AndreaFavero71/CUBOTino_micro/src/Cubotino_m_settings_default.txt

{
"frameless_cube": "auto",
"disp_width": "240",
"disp_height": "135",
"disp_offsetL": "40",
"disp_offsetT": "53",
"camera_width_res": "640",
"camera_height_res": "480",
"s_mode": "7",
"kl": "0.95",
"x_l": 0,
"x_r": 0,
"y_u": 0,
"y_b": 0,
"warp_fraction": 7.8,
"warp_slicing": 3,
"square_ratio": "1",
"rhombus_ratio": "0.3",
"delta_area_limit": "0.7",
"sv_max_moves": "20",
"sv_max_time": "2",
"collage_w": "1024",
"marg_coef": "0.1",
"cam_led_bright": ".5",
"detect_timeout": "40",
"show_time": "7",
"warn_time": "1.5",
"quit_time": "4.5",
"cover_self_close": "true",
"vnc_delay": "0.5",
"built_by": "",
"built_by_x": "25",
"built_by_fs": "22",
"fcs_delay": "3.0"
}
