AndreaFavero71/CUBOTino_micro/src/Cubotino_m_settings_AF3.txt

{
"frameless_cube": "auto",
"disp_width": "240",
"disp_height": "135",
"disp_offsetL": "40",
"disp_offsetT": "53",
"camera_width_res": "640",
"camera_height_res": "480",
"s_mode": "7",
"kl": "0.95",
"x_l": 32,
"x_r": 86,
"y_u": 32,
"y_b": 58,
"warp_fraction": 7.7,
"warp_slicing": 3.0,
"square_ratio": "1",
"rhombus_ratio": "0.3",
"delta_area_limit": "0.7",
"sv_max_moves": "20",
"sv_max_time": "2",
"collage_w": "1024",
"marg_coef": "0.07",
"cam_led_bright": "1.0",
"detect_timeout": "40",
"show_time": "7",
"warn_time": "1.5",
"quit_time": "4.5",
"cover_self_close": "true",
"vnc_delay": "0.5",
"built_by": "",
"built_by_x": "25",
"built_by_fs": "22"
}
