AndreaFavero71/CUBOTino_micro/stl/SOCs_-9.stl

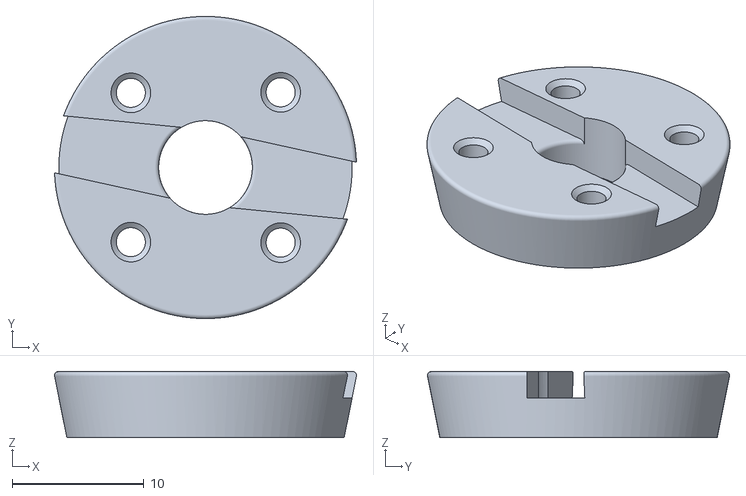
[picture p3: CAD file, 2023-03-04]
stl/SOCs_-9.stl
22.9 x 22.9 x 5.00
