AndreaFavero71/CUBOTino_micro/stp/Cover_Perfboard_hole.stp

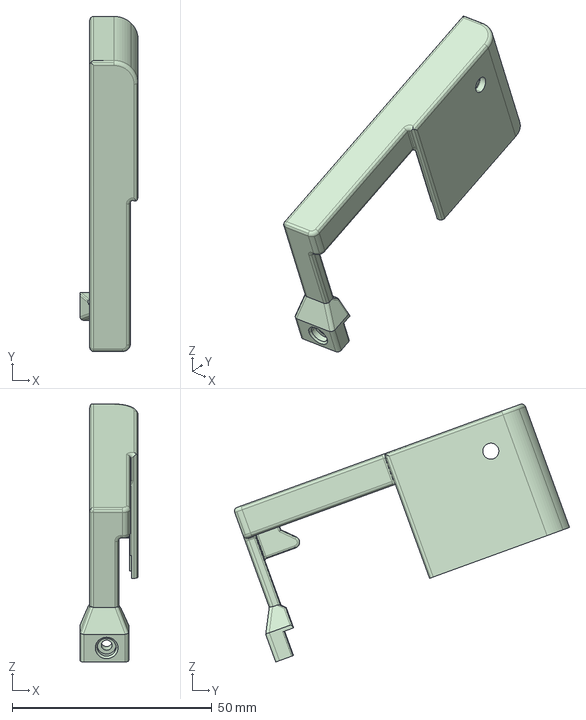
[picture p4: CAD file, 2024-01-12]
stp/Cover_Perfboard_hole.stp
14.6 x 83.9 x 64.6 mm
