AndreaFavero71/CUBOTino_micro/stp/Baseplate_addition.stp

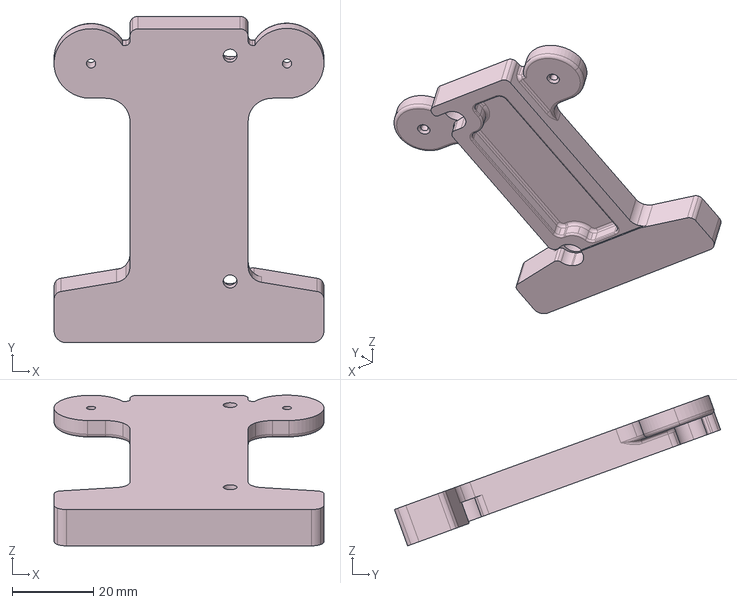
[picture p5: CAD file, 2023-05-06]
stp/Baseplate_addition.stp
66.3 x 80.1 x 37.0 mm
