AndreaFavero71/CUBOTino_micro/stp/Baseplate_L_leg.stp

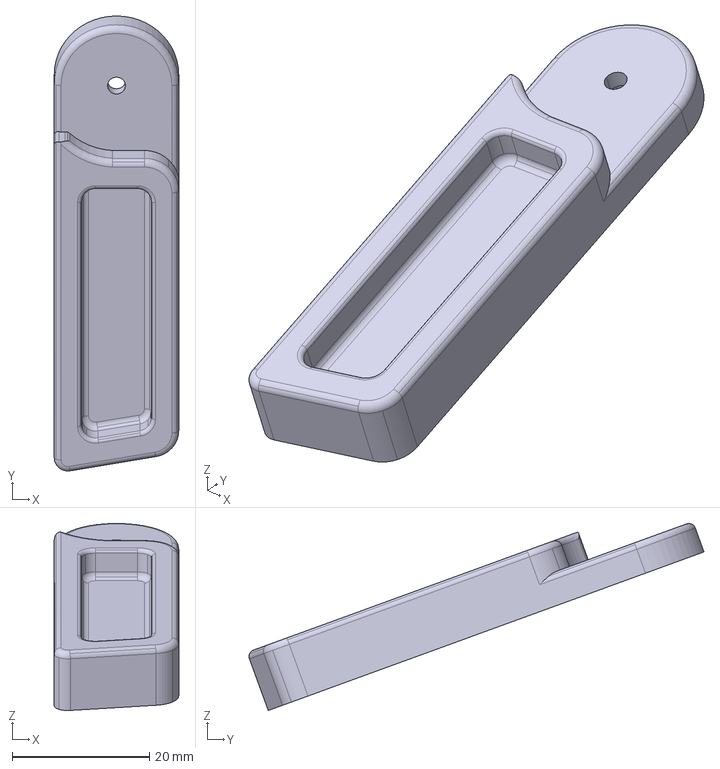
[picture p6: CAD file, 2023-05-06]
stp/Baseplate_L_leg.stp
18.1 x 66.2 x 27.2 mm
