AndreaFavero71/CUBOTino_micro/stp/Structure.stp

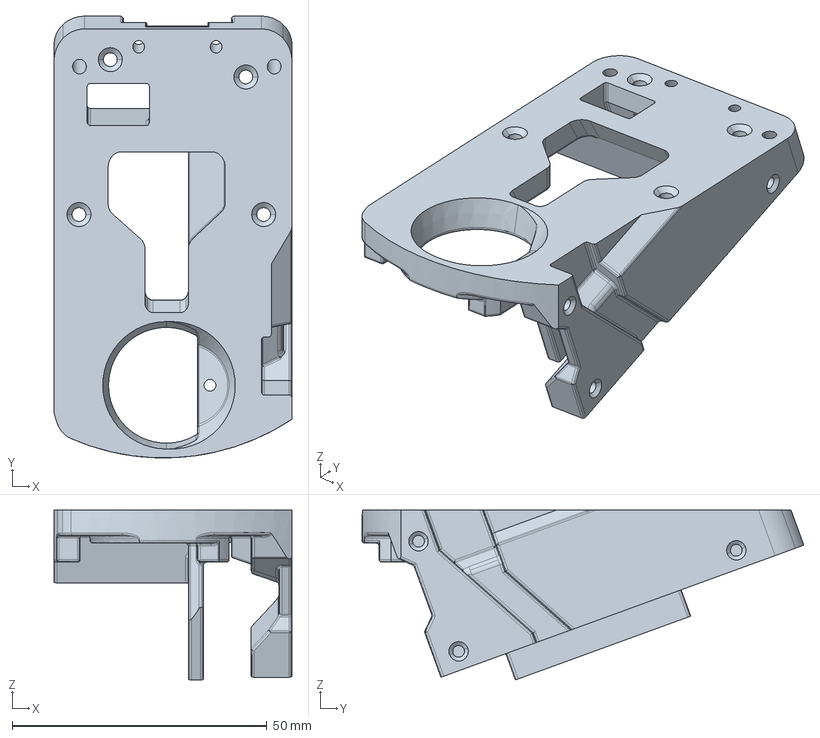
[picture p7: CAD file, 2023-03-11]
stp/Structure.stp
46.7 x 86.7 x 33.3 mm
