AndreaFavero71/CUBOTino_micro/stp/Holder.stp

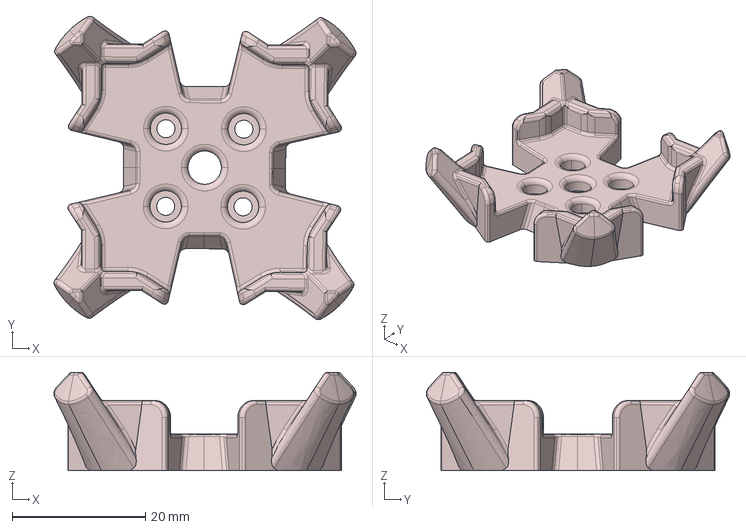
[picture p8: CAD file, 2023-03-07]
stp/Holder.stp
45.3 x 45.5 x 14.7 mm
