AndreaFavero71/CUBOTino_micro/stp/PiCamera_holder.stp

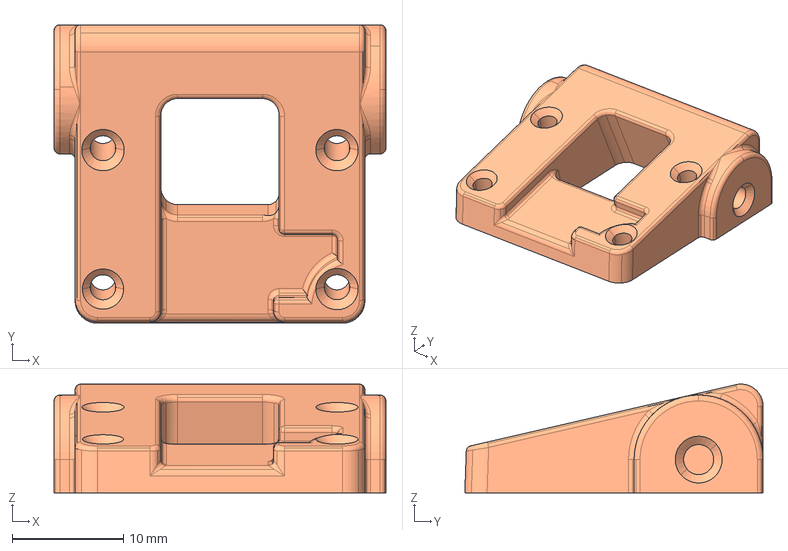
[picture p9: CAD file, 2023-03-04]
stp/PiCamera_holder.stp
29.8 x 26.8 x 9.77 mm
