AndreaFavero71/CUBOTino_micro/stp/PiCamera_frame.stp

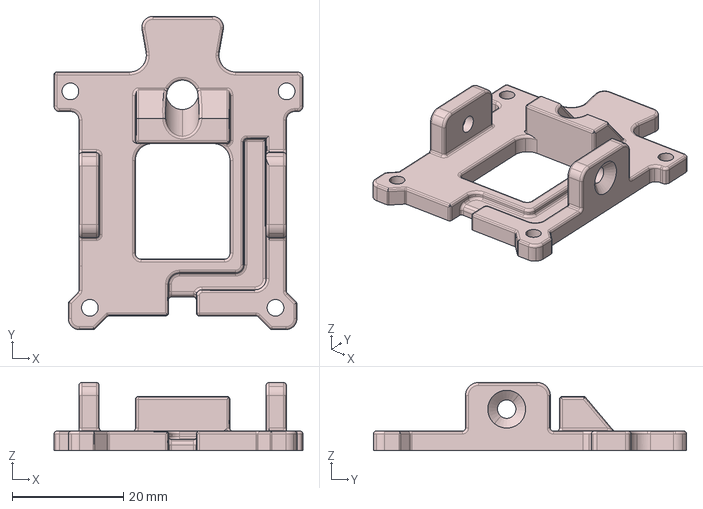
[picture p10: CAD file, 2023-03-04]
stp/PiCamera_frame.stp
44.8 x 56.3 x 12.2 mm
