AndreaFavero71/CUBOTino_micro/stp/SOC_0.stp

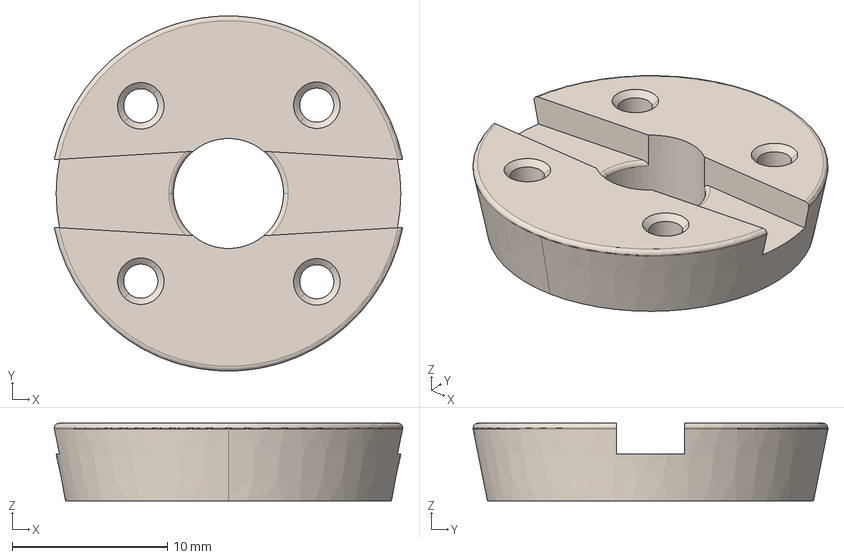
[picture p11: CAD file, 2023-03-04]
stp/SOC_0.stp
22.5 x 22.9 x 5.00 mm
