AndreaFavero71/CUBOTino_micro/stp/Baseplate.stp

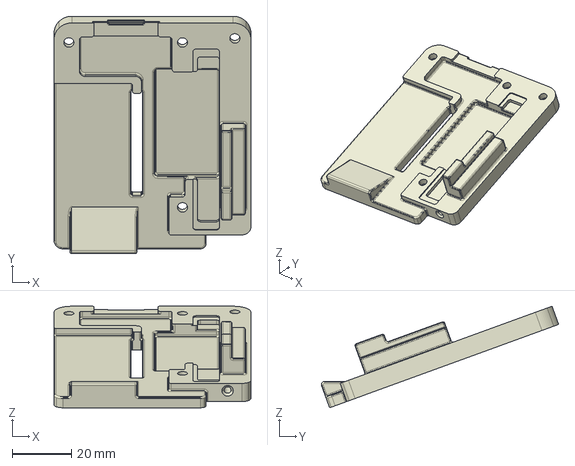
[picture p12: CAD file, 2023-03-04]
stp/Baseplate.stp
66.3 x 79.8 x 34.2 mm
