AndreaFavero71/CUBOTino_micro/stp/Hinge.stp

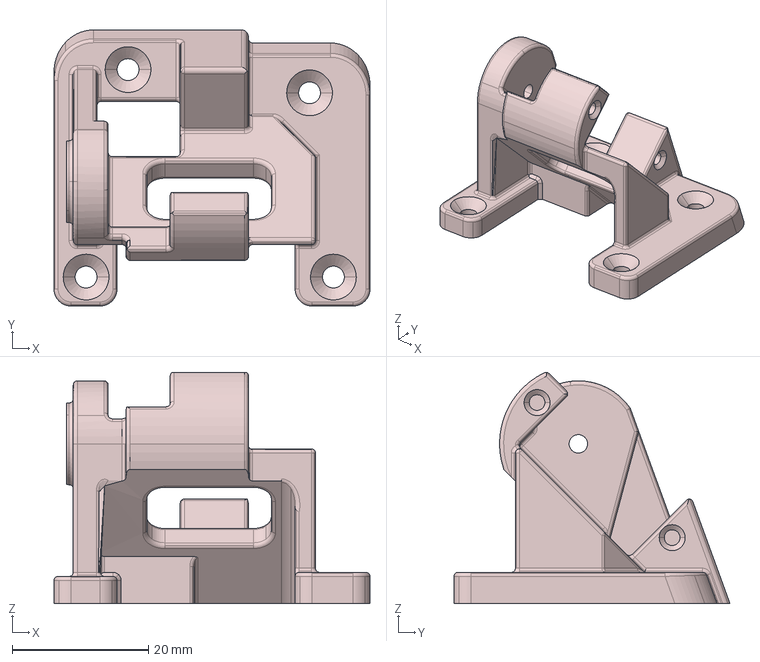
[picture p13: CAD file, 2023-03-04]
stp/Hinge.stp
46.3 x 40.5 x 33.9 mm
