AndreaFavero71/CUBOTino_micro/stp/Lifter.stp

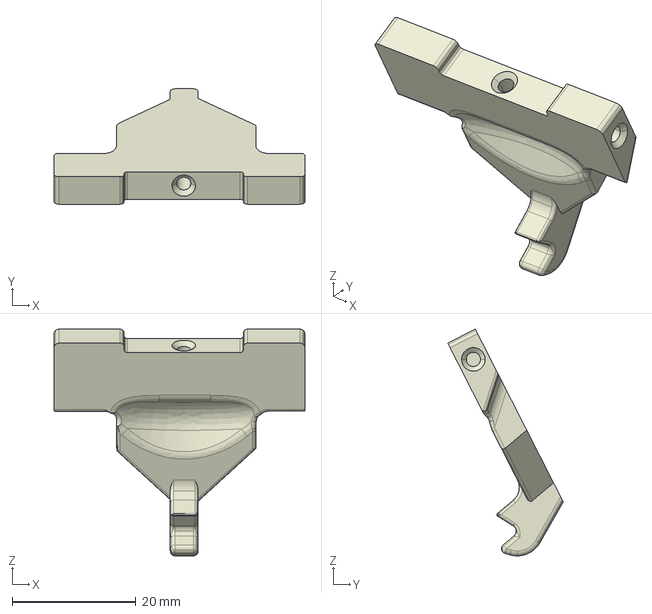
[picture p14: CAD file, 2023-03-04]
stp/Lifter.stp
40.6 x 18.7 x 36.7 mm
