AndreaFavero71/CUBOTino_micro/stp/Top_cover.stp

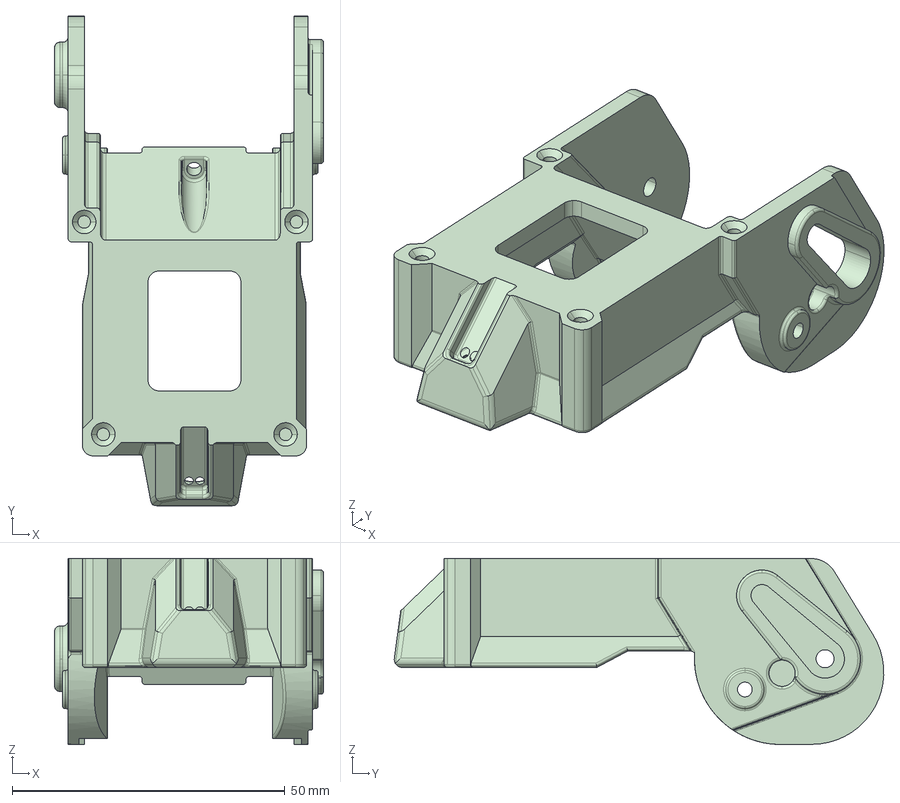
[picture p15: CAD file, 2023-03-04]
stp/Top_cover.stp
49.3 x 89.7 x 34.1 mm
