AndreaFavero71/CUBOTino_micro/(list of files, cad)

Other CAD files:
stp/Baseplate_R_leg.stp
stp/Cover_led_hole.stp
stp/Cover.stp
stp/SOC_+5.stp
stp/SOC_+9.stp
stl/Baseplate_L_leg.stl
stl/Baseplate_R_leg.stl
stl/Baseplate_addition.stl
stl/Cover.stl
stl/Cover_Perfboard_hole.stl
stl/Cover_led_hole.stl
stl/Lifter.stl
stl/SOC_+5.stl
stl/SOC_+9.stl
stl/SOC_-5.stl
stl/SOC_0.stl
stp/SOC_-5.stp
stp/SOC_-9.stp
