AndreaFavero71/CUBOTino_micro/src/Cubotino_m.py

#!/usr/bin/python
# coding: utf-8

""" 
#############################################################################################################
#  Andrea Favero, 15 April 2024
#
#
#  This script relates to CUBOTino micro, an extremely small and simple Rubik's cube solver robot 3D printed
#  CUBOTino micro is the smallest version of the CUBOTino versions
#  Demo at https://youtu.be/EbOHhvg2tJE
#  Instructions: https://www.instructables.com/member/AndreaFavero/instructables/
#
#  This is the core script, that interracts with few other files.
#  Many functions of this code have been developed on 2021, for my first robot (https://youtu.be/oYRXe4NyJqs).
#
#  The cube status is detected via a camera system (piCamera) and OpenCV .
#  Kociemba solver is used foer the cube solution (from: https://github.com/hkociemba/RubiksCube-TwophaseSolver)
#  Credits to Mr. Kociemba for his great job !
#  Search for CUBOTino autonomous on www.intructable.com, to find more info about this robot.
#
#  Developped on:
#  - Raspberry Pi Zero 2
#  - Raspberry Pi OS (Legacy) A port of Debian Buster with security updates and desktop environment
#    (Linux raspberry 5.10.103-v7+ #1529 SMP Tue 8 12:21:37 GMT 2022 armv71 GNU/Linux)
#  - OpenCV cv2 ver: 4.1.0
#  - PiCamera v1.3
#  - Numpy: 1.21.4
#
#############################################################################################################
"""

# __version__ variable
version = '1.1   15 April 2024'


################  setting argparser for robot remote usage, and other settings  #################
import argparse

# argument parser object creation
parser = argparse.ArgumentParser(description='CLI arguments for Cubotino_m.py')

# --version argument is added to the parser
parser.add_argument("-v", "--version", help='Display script version.', action='version',
                    version=f'%(prog)s ver:{version}')

# --fast argument is added to the parser
parser.add_argument("-f", "--fast", action='store_true',
                    help="From Flip-Up to close_cover in one movement instead of two")

# --debug argument is added to the parser
parser.add_argument("-d", "--debug", action='store_true',
                    help="Activates printout of settings, variables and info for debug purpose")

# --no_animation argument is added to the parser
parser.add_argument("--no_animation", action='store_true',
                    help="Deactivates the animation on display and screen")

# --cv_wow argument is added to the parser
parser.add_argument("--cv_wow", action='store_true',
                    help="Activates the cv_wow (image analysis steps) on screen")

# --F_deg argument is added to the parser
parser.add_argument("-F", "--F_deg", action='store_true',
                    help="CPU temperature in Fahrenheit degrees")

# --cycles argument is added to the parser
parser.add_argument("-c", "--cycles", type=int, 
                    help="Input the number of automated scrambling and solving cycles")

# --pause argument is added to the parser
parser.add_argument("-p", "--pause", type=int, 
                    help="Input the pause time, in secs, between automated cycles")

# --shutoff argument is added to the parser
parser.add_argument("-s", "--shutoff", action='store_true',
                    help="Shuts the RPI off, after the automated scrambling and solving cycles")

# --timer argument is added to the parser
parser.add_argument("-t", "--timer", action='store_true',
                    help="Timer is visualized after the scrambling function (max 1h)")

# --picamera_test argument is added to the parser
parser.add_argument("--picamera_test", action='store_true',
                    help="Visualizes PiCamera images for test purpose")

# --no_motors argument is added to the parser
parser.add_argument("--no_motors", action='store_true',
                    help="Excludes servos and motor for test purpose")

# --no_btn argument is added to the parser
parser.add_argument("--no_btn", action='store_true',
                    help="Starts the first solving cycles without using the button")

args = parser.parse_args()   # argument parsed assignement
# ###############################################################################################







def import_parameters(debug=False):
    """ Function to import parameters from a json file, to make easier to list/document/change the variables
        that are expected to vary on each robot."""
       
    from Cubotino_m_settings_manager import settings as settings  # settings manager Class
    
    global frameless_cube, camera_width_res, camera_height_res, s_mode
    global kl, x_l, x_r, y_u, y_b, w_f, w_s, square_ratio, rhombus_ratio
    global delta_area_limit, sv_max_moves, sv_max_time, collage_w, marg_coef, cam_led_bright, cam_led_auto
    global detect_timeout, show_time, warn_time, quit_time, cover_self_close, vnc_delay, fcs_delay
    global built_by, built_by_x, built_by_fs

    
    
    try:                                               # tentative
        sett = settings.get_settings()                 # settings are retrieved from the settings Class
        frameless_cube = sett['frameless_cube']        # cube frameless (with/without black frame around the facelets)
        camera_width_res = sett['camera_width_res']    # Picamera resolution on width 
        camera_height_res = sett['camera_height_res']  # Picamera resolution on heigh
        s_mode = sett['s_mode']                        # camera setting mode (pixels binning)
        kl = sett['kl']                                # coff. for PiCamera stabili acceptance
        x_l = sett['x_l']                              # image crop on left (before warping)
        x_r = sett['x_r']                              # image crop on right (before warping)
        y_u = sett['y_u']                              # image crop on top (before warping)
        y_b = sett['y_b']                              # image crop on bottom (before warping)
        w_f = sett['warp_fraction']                    # coeff for warping the image
        w_s = sett['warp_slicing']                     # coeff for cropping the bottom warped image

        square_ratio = sett['square_ratio']            # acceptance threshold for square sides difference
        rhombus_ratio = sett['rhombus_ratio']          # acceptance threshold for rhombus axes difference
        delta_area_limit = sett['delta_area_limit']    # acceptance threshold for facelet area dev from median
        sv_max_moves = sett['sv_max_moves']            # max moves requested to the Kociemba solver
        sv_max_time = sett['sv_max_time']              # timeout requested to the Kociemba solver
        collage_w = sett['collage_w']                  # image width for unfolded cube collage
        marg_coef = sett['marg_coef']                  # cropping margin arounf faces for immage collage
        cam_led_bright = sett['cam_led_bright']        # PWM level for the 3W led at Top_cover
        detect_timeout = sett['detect_timeout']        # timeout for cube status detection
        show_time = sett['show_time']                  # showing time of the unfolded cube image collage
        warn_time = sett['warn_time']                  # solve button pressing time before get a worning
        quit_time = sett['quit_time']                  # solve button pressing time before the quit process
        vnc_delay = sett['vnc_delay']                  # delay for cube moving to next face at scan (for VNC viewer)
        built_by = sett['built_by']                    # maker's name to add on the Cubotino logo
        built_by_x = sett['built_by_x']                # x coordinate for maker's name on display
        built_by_fs = sett['built_by_fs']              # font size for the maker's name on display
        fcs_delay = sett['fcs_delay']                  # delay in secs to switch to Fix Coordinates System for facelets position
        cover_self_close = sett['cover_self_close']    # cover_self_close parameter 
        
        if debug:                                      # case debug variable is set true
            fname = settings.get_settings_fname()      # settings filename is retrieved
            print('\nImporting servos settings from the text file:', fname)  # feedback is printed to the terminal
            for param, s in sett.items():              # iteration over the settings dict
                print(param,': ', s)                   # feedback is printed to the terminal
            print()                                    # prints an empty line
        
        return True, sett                              # return True for loaded settings and the sett dictionary
    
    except:   # exception will be raised if json keys differs, or parameters cannot be converted to int/float
        print('Error at imported_parameters function in Cubotino_m.py')   # feedback is printed to the terminal                                  
        return False, ''                               # return robot_init_status variable, that is False








def import_libraries():
    """ Import of the needed libraries.
        These librries are imported after those needed for the display management.
        Kociemba solver is tentatively imported considering three installation/copy methods."""
    
    global camera_set_gains, dist, PiRGBArray, PiCamera, servo, rm, GPIO, median, dt, sv, cubie
    global np, math, time, cv2, os, pathlib
    
    # import custom libraries
    from Cubotino_m_settings_manager import settings as settings   # custom library managing the settings from<>to the settings files
    import Cubotino_m_set_picamera_gain as camera_set_gains  # script that allows to fix some parameters at picamera
    import Cubotino_m_servos as servo                     # custom library controlling Cubotino servos and led module
    import Cubotino_m_moves as rm                         # custom library, traslates the cuber solution string in robot movements string

    # import non-custom libraries
    from picamera.array import PiRGBArray                 # Raspberry pi specific package for the camera, using numpy array
    from picamera import PiCamera                         # Raspberry pi specific package for the camera
    from statistics import median                         # median is used as sanity check while evaluating facelets contours
    import os.path, pathlib                               # import libraries for file and folder management
    import RPi.GPIO as GPIO                               # import RPi GPIO library
    import datetime as dt                                 # mainly used as timestamp, like on data logging
    import numpy as np                                    # data array management
    import math                                           # math package
    import time                                           # time package
    import cv2                                            # computer vision package
    import os                                             # os is imported to ensure the file presence check/make
    
    print('CV2 version: ', cv2.__version__)               # print to terminal the cv2 version
    
    # Up to here Cubotino logo is shown on display
    disp.show_on_display('LOADING', 'SOLVER', fs1=37, y2=75, fs2=42)  # feedback is printed to the display
    disp.set_backlight(1)                                 # display backlight is turned on, in case it wasn't

    
    # importing Kociemba solver (this import takes quite some time to be uploaded)
    try:
        import twophase.solver as sv                  # import Kociemba solver installed in venv
        import twophase.cubie as cubie                # import cubie Kociemba solver library part
        twophase_solver_found = True                  # boolean to track no exception on import the installed solver
        if debug:                                     # case debug variable is set true on __main__
            print('found Kociemba solver installed')  # feedback is printed to the terminal
    except:
        twophase_solver_found = False                 # boolean to track no exception on import the installed solver
    
    if not twophase_solver_found:    # case no one solver has been imported
        print('\nnot found Kociemba solver')              # feedback is printed to the terminal
        disp.show_on_display('NO SOLVER', 'FOUND', fs1=32, fs2=42) # feedback is printed to the display
        time.sleep(5)                                     # delay to let user the time to read the display
        quit_func(quit_script=True)                       # script is quitted






def press_to_start():
    """ Print PRESS TO START to display, and waits until the solve button is pressed to escape the infinite loop"""
    
    global robot_idle
    
    choice = ''                                # variable to store the user choice (solve or scramble)
    robot_idle = True                          # robot is idling
    disp.set_backlight(1)                      # display backlight is turned on, in case it wasn't
    txt1 = '<  SOLVE'                          # text to print at first row
    txt2 = '<  SCRAMBLE'                       # text to print at second row
    fs_text1 = 33                              # font size at first row
    fs_text2 = 30                              # font size at second row
    disp.show_on_display(txt1, txt2, x1=0, x2=0, y2=85, fs1=fs_text1, fs2=fs_text2)   # request user to touch the button to start a cycle
    ref_time = time.time()                     # current time is assigned to ref_time variable
    cubotino_logo = False                      # boolean to alternate text with Cubotino logo on display
    display_time = 1                           # time (in sec) for each display page
    while True:                                # infinite loop
        if time.time() - ref_time >= display_time:   # time is checked
            if not cubotino_logo:              # case cubotino logo boolean is false  
                disp.show_cubotino(built_by, built_by_x, built_by_fs)  # shows the Cubotino logo on the display, for delay time
                ref_time = time.time()         # current time is assigned to ref_time variable
                cubotino_logo = True           # cubotino logo boolean is set true                           
            else:                              # case cubotino logo boolean is false  
                disp.show_on_display(txt1, txt2, x1=0, x2=0,  y2=85, fs1=fs_text1, fs2=fs_text2)    # request user to touch the button to start a cycle
                ref_time = time.time()         # current time is assigned to ref_time variable
                cubotino_logo = False          # cubotino logo boolean is set false
            time.sleep(0.05)                   # little sleep time 
            
        if not GPIO.input(solve_btn):          # case solve_button is pressed
            return 'solve'                     # 'solve' string is returned
        
        if not GPIO.input(scramble_btn):       # case scramble_button is pressed
            return 'scramble'                  # 'solve' string is returned
        
        if not btn:                            # case the btn is ignored via argparse
            print('Cycle automatically started because of the --no_btn argument')
            return 'solve'                     # 'solve' string is returned






def check_screen_presence():
    """ Checks if a display is connected, eventually via VNC; This is not the little display (SPI) ...."""
    
    import os
    
    if 'DISPLAY' in os.environ:                          # case the environment variable DISPLAY is set to 1 (there is a display)
        if debug:                                        # case debug variable is set true on __main__
            print('display function is availbale')       # feedback is printed to the terminal
        return True                                      # function returns true, meaning there is a screen connected
    else:                                                # case the environment variable DISPLAY is set to 0 (there is NOT a display)
        if debug:                                        # case debug variable is set true on __main__
            print('display function is not availbale')   # feedback is printed to the terminal
        return False                                     # function returns false, meaning there is NOT a screen connected







def webcam():
    """ Set the camera and its resolution."""
    
    global camera, PiRGBArray
    
    # PiCamera is set as camera object, with binning. Framerate range limited to 10 allows longer exposure time (when needed)
    # higher framerate does not really speed up the cube reading process.

#     s_mode = 7    #(AF 7)   # PiCamera V1.3: sensor mode 7 means 4x4 binning, 4:3, Full Field of View
                              # PiCamera V2:   sensor mode 4 means 2x2 binning, 4:3, Full Field of View

    camera = PiCamera(sensor_mode=s_mode) #, framerate_range = (1/20, 1))  
    
    rawCapture = PiRGBArray(camera)        # returns (uncoded) RGB array from the camera
    # camera_width_res = 640   #(AF 640)   # PiCamera width resolution setting (other possible values: 800 or 1088)
    # camera_height_res = 480   #(AF 480)  # PiCamera height resolution setting (other possible values: 544 or 720)
    
    width = camera_width_res               # image width
    height = camera_height_res             # image height
    camera.resolution = (width, height)    # camera's resolution is set
    time.sleep(0.15)                       # little delay to let the camera setting
    
    binning = camera.sensor_mode           # PiCamera sensor_mode is checked
    time.sleep(0.15)                       # little delay to let the camera setting
    
    if debug:                                      # case debug variable is set true on __main__
        #  sensor_mode answer from the camera is interpreted
        if binning <=3:                            # case the binning is <=3 it means no binning
            binning='none'                         # binning variable is set to none
        elif binning == 4 or binning == 5:         # case the binning is 4 or 5 it means binning 2x2
            binning='2x2'                          # binning variable is set to 2x2
        elif binning > 5:                          # case binning is bigger than 5 it means binning 4x4
            binning='4x4 if PiCamera V1.3, 2x2 if V2'  # binning 4x4 when PiCamera V1.3, 2x2 when PiCamera V2
        print('PiCamera mode (binning):', binning) # feedback is printed to the terminal
    
    # case cube side is zero, no request to stop the robot and not automated cycles
    if side == 0 and not robot_stop and cycles_num == 0 and not picamera_test:
        print('PiCamera resolution (width x height): ',camera.resolution)  # feedback is printed to the terminal
    
    return camera, rawCapture, width, height







def robot_camera_warmup(camera, start_time):
    """ According to PiCamera documentation it is required a couple of seconds to warmup the camera.
    If the robot start-button is pressed right after placing the cube, the camera has to update the gains previously set,
    that means from when the camera was pointing the black cube support; this can take up to 20 secs to get all
    the gains stable (awb gains are rather slow to update).
    Much different is when the cube is on the cube support for few secs when the button is pressed.
    To properly cover all the possible situations, this fuction releases the camera warm-up phase only after
    all the gains are stable, meaning an absolute variation < 2% from the average of last 2 seconds."""
    

    if not robot_stop:
        disp.show_on_display('CAMERA', 'SETUP', fs1=40, fs2=42)  # feedback is printed to the display
        print('\nPiCamera: waiting for AWB and Exposure gains to get stable')  # feedback is printed to the terminal
        if debug:                              # case debug variable is set true on __main__
            print('camera set in auto mode')   # feedback is printed to the terminal
        camera.exposure_mode = 'auto' # set to auto exposure at the start, to adjust according to light conditions
        time.sleep(0.05)              # not found documentation if a delay is needed after this PiCamera setting 
        camera.awb_mode = 'auto'      # set to auto white balance at the start, to adjust according to light conditions
        time.sleep(0.05)              # not found documentation if a delay is needed after this PiCamera setting
        camera.shutter_speed = 0      # set to shutter speed to auto at the start, to adjust according to light conditions
        time.sleep(0.05)              # not found documentation if a delay is needed after this PiCamera setting
        
        a_gain_list=[]                # list to store the Picamera analog gain, during warmup period
        d_gain_list=[]                # list to store the Picamera digital gain, during warmup period
        awb_blue_list=[]              # list to store the Picamera AWB gain, for blue, during warmup period
        awb_red_list=[]               # list to store the Picamera AWB gain, for red, during warmup period
        exp_list=[]                   # list to store the Picamera exposure time, during warmup period
        t_list=[]                     # list to store the warmup progressive time of checkings
        
        # kl = 0.95     #(AF 0.95)    # lower koefficient to define acceptance bandwidth (95%)
        ku = 2-kl                     # Upper koefficient to define acceptance bandwidth (105%)
        pts = 8                       # amount of consecutive datapoints to analyse if parameters within acceptable range
        
        t_start=time.time()           # time reference is assigned as reference for the next task
        
        while time.time()-t_start <20:       # timeout for camera warm-up phase is 20 seconds
            if robot_stop:                   # case the robot has been requested to stop
                PiCamera_param=()            # empty tuple is assigned to PiCamera_param variable
                return PiCamera_param        # PiCamera_param is returned
                
            frame, w, h = read_camera()                                 # camera start reading the cube, and adjusts the awb/exposure
            a_gain=camera.analog_gain                                   # analog gain is inquired to the PiCamera
            d_gain=camera.digital_gain                                  # digital gain is inquired to the PiCamera
            awb_gains=camera.awb_gains                                  # awb blue and red gains are inquired to the PiCamera
            exposure=camera.exposure_speed                              # exposure is inquired to the PiCamera
            
            a_gain_list.append(round(float(a_gain),2))                  # analog gain is appended to a list
            d_gain_list.append(round(float(d_gain),2))                  # digital gain is appended to a list
            awb_blue_list.append(round(float(awb_gains[0]),2))          # awb blue part gain is appended to a list
            awb_red_list.append(round(float(awb_gains[1]),2))           # awb blue part gain is appended to a list
            exp_list.append(exposure)                                   # exposure time (micro secs) is appended to a list
            t_list.append(round(time.time()- t_start,2))                # time (from AWB and Exposure start adjustement) is appended to a list
            
            a_check=False                                               # a flag is negatively set for analog gain (being stable...)
            d_check=False                                               # a flag is negatively set for digital gain (being stable...)
            awb_blue_check=False                                        # a flag is negatively set for awb blue gain (being stable...)
            awb_red_check=False                                         # a flag is negatively set for awb red gain (being stable...)
            exp_check=False                                             # a flag is negatively set for the exposure time (being stable...)
            
            if len(a_gain_list) > pts:                                  # requested a minimum amount of datapoints
                check = a_gain_list[-1]/(sum(a_gain_list[-pts:])/pts)   # last analog gain value is compared to the average of last pts points
                if check > kl and check < ku:                           # if comparison within acceptance boundaries
                    a_check=True                                        # flag is positively set for this gain

                check = d_gain_list[-1]/(sum(d_gain_list[-pts:])/pts)   # last digital gain value is compared to the average of last pts points
                if check > kl and check < ku:                           # if comparison within acceptance boundaries
                    d_check=True                                        # flag is positively set for this gain               
            
                check = awb_blue_list[-1]/(sum(awb_blue_list[-pts:])/pts) # last awb_blue gain is compared to the average of last pts points
                if check > kl and check < ku:                           # if comparison within acceptance boundaries
                    awb_blue_check=True                                 # flag is positively set for this gain    
                    
                check = awb_red_list[-1]/(sum(awb_red_list[-pts:])/pts) # last awb_red gain is compared to the average of last pts points
                if check > kl and check < ku:                           # if comparison within acceptance boundarie
                    awb_red_check=True                                  # flag is positively set for this gain
                
                check = exp_list[-1]/(sum(exp_list[-pts:])/pts)         # last exposure time is compared to the average of last pts points
                if check > kl and check < ku:                           # if comparison within acceptance boundarie
                    exp_check=True                                      # flag is positively set for the exposure time                
         
                if a_check and d_check and awb_blue_check and awb_red_check and exp_check: # if all gains are stable
                    PiCamera_param=(a_gain, d_gain, awb_gains, exposure)  # latest parameters returned by the PiCamera are assigned to a tuple
                    break                                                 # camera warmup while loop cab be break

            if screen and not robot_stop:            # case screen variable is set true on __main__
                if fixWindPos:                       # case the fixWindPos variable is chosen
                    cv2.namedWindow('cube')          # create the cube window
                    cv2.moveWindow('cube', 0,0)      # move the window to (0,0)
                cv2.imshow('cube', frame)            # shows the frame 
                cv2.waitKey(1)                       # refresh time is minimized to 1ms  
        
        print(f'PiCamera: AWB and Exposure being stable in {round(t_list[-1],1)} secs')
        if screen:                                        # case screen variable is set true on __main__
            if debug:                                     # case debug variable is set true on __main__
                print('\nPiCamera warmup function:')      # feedback is printed to the terminal
                print('analog_gain_list',a_gain_list)     # feedback is printed to the terminal
                print('digital_gain_list',d_gain_list)    # feedback is printed to the terminal
                print('awb_blue_list',awb_blue_list)      # feedback is printed to the terminal
                print('awb_red_list',awb_red_list)        # feedback is printed to the terminal
                print('camera exp_list', exp_list)        # feedback is printed to the terminal
                print('time:', t_list)                    # feedback is printed to the terminal
                print('datapoints:', len(t_list))         # feedback is printed to the terminal
        
        disp.clean_display()                              # cleans the display
    
    return PiCamera_param







def robot_consistent_camera_images(camera, PiCamera_param, start_time):
    """ Picamera is left in Auto mode for Exposure and AWB, untill the first 9 facelets of first side are detected.
    For consistent color detection, on the following sides, these two parameters are retrieved from PiCamera right after
    the first side detection, and se back to PiCamera as 'manual' parametes.
    This prevents the PiCamera to keep adjusting the AWB and Exposure while reading the following 5 cube faces (sides)."""
    
    if robot_stop:        # case the robot has been requested to stop
        return            # function is terminated
    
    disp.show_on_display('MEASURING', 'EXPOSURE', fs1=30, fs2=34)    # feedback is printed to the display
    
    a_gain = PiCamera_param[0]                          # analog gain picamera setting when warmup got stable
    d_gain = PiCamera_param[1]                          # digital gainpicamera setting when warmup got stable
    awb_gains = PiCamera_param[2]                       # AutoWhiteBalance gain picamera setting when warmup got stable
    
    if not robot_stop:                                  # case of no request to stop the robot
        print('\nPiCamera: Reading the exposure time on four cube sides')  # feedback is printed to the terminal
        if debug:                                       # case debug variable is set true on __main__
            print('camera awb set off')                 # feedback is printed to the terminal
    
    camera.awb_mode = 'off'                             # sets white balance off
    time.sleep(0.05)                                     # small (arbitrary) delay after setting a new parameter to PiCamera
    camera.awb_gains = awb_gains                        # sets AWB gain to PiCamera, for consinsent images 
    time.sleep(0.05)                                     # small (arbitrary) delay after setting a new parameter to PiCamera
    camera_set_gains.set_analog_gain(camera, a_gain)    # sets analog gain to PiCamera, for consinsent images
    time.sleep(0.05)                                     # small (arbitrary) delay after setting a new parameter to PiCamera
    camera_set_gains.set_digital_gain(camera, d_gain)   # sets digital gain to PiCamera, for consinsent images
    time.sleep(0.05)                                     # small (arbitrary) delay after setting a new parameter to PiCamera
    camera.shutter_speed = 0      # set the shutter speed to auto at the start, to adjust according to light conditions
    time.sleep(0.05)                                     # small (arbitrary) delay after setting a new parameter to PiCamera

    
    # PiCamera exposure is inquired to PiCaera on 4 cube sides reachable via a simple cube flip, to later fix an average exposure time
    exp_list=[]                                         # list to store the Picamera exposure time, for the first 4 faces
    exp_list.append(camera.exposure_speed)              # read picamera exposure time (microsec) on first face
    
    for i in range(3):                                  # iterate over the next 3 faces reachable via a single cube flip    
        robot_to_cube_side(1,cam_led_bright)            # flipping the cube, to reach the next side 
        if screen and not robot_stop:                   # case screen variable is set true on __main__
            frame, w, h = read_camera()                 # camera start reading the cube, and adjusts the awb/exposure
            if fixWindPos:                              # case the fixWindPos variable is chosen
                cv2.namedWindow('cube')                 # create the cube window
                cv2.moveWindow('cube', 0,0)             # move the window to (0,0)
            cv2.imshow('cube', frame)                   # shows the frame 
            cv2.waitKey(300)                            # refresh time of 0.3s, used for camera exposure reading
        elif not screen and not robot_stop:             # case there are no screen connected     
            time.sleep(0.1)                             # small (arbitrary) delay before reading the exposure time at PiCamera
        exp_list.append(camera.exposure_speed)          # read picamera exposure time (microsec) on the face i+1
    
    robot_to_cube_side(1,cam_led_bright)                # flipping the cube, to reach the 1st face to be scanned
    shutter_time = int(sum(exp_list)/len(exp_list))     # set the shutter time to the average exposure time of UBDF faces
    camera.shutter_speed = shutter_time                 # sets the shutter time to the PiCamera, for consinstent images
    time.sleep(0.05)                                    # small (arbitrary) delay after setting a new parameter to PiCamera 
    
    if screen:
        print(f'Exposure time measured on 4 cube sides, in: {round(time.time()-start_time,1)} secs')# feedback is printed to the terminal
    
    if debug:                                                   # case debug variable is set true on __main__
        print('\nexposure time on UBDF faces : ', exp_list)     # feedback is printed to the terminal
        print('\naverage exposure time: ', int(sum(exp_list)/len(exp_list)), 'micro secs') # feedback is printed to the terminal
        print('shutter_speed time set by PiCamera: ',camera.shutter_speed, ' micro secs')    # feedback is printed to the terminal
        print('\nPiCamera parameters, for consistent images, are set to:')                   # feedback is printed to the terminal
        print('analog_gain:',round(float(a_gain),2))      # feedback is printed to the terminal
        print('digital_gain:',round(float(d_gain),2))     # feedback is printed to the terminal
        print('awb_mode:', camera.awb_mode)               # feedback is printed to the terminal
        print('awb_blue:',round(float(awb_gains[0]),2))   # feedback is printed to the terminal
        print('awb_red:',round(float(awb_gains[1]),2))    # feedback is printed to the terminal
        print(f'camera shutter_speed (0=auto): {shutter_time} micro secs, as average measured on UBDF sides') # feedback is printed to the terminal
    
    disp.clean_display()   # cleans the display






def read_camera():
    """ Returns the camera reading, and dimensions."""
    
    global previous_time

    camera.capture(rawCapture, format='bgr')                      # bgr is the picamera format directly compatible with CV2
    frame = rawCapture.array                                      # picamera array allows usgae of numpy array
    if len(frame)==0:                                             # case the frame is empty
        print('Webcam frame not available')                       # feedback is print to the terminal
    
    else:                                                         # case the frame is not empty
        if not picamera_test:                                     # case picamera_test is false
            frame, w, h = frame_cropping(frame, width, height, x_l, x_r, y_u, y_b)  # frame is cropped in order to limit the image area to analyze
            frame, w, h = warp_image(frame, w, h, w_f, w_s)       # frame is warped to have a top like view toward the top cube face
            scale = 0.75 if cv_wow else 0.8                       # scaling factor according to cv_wow i 
            frame, w, h = frame_resize(frame, w, h, scale=scale)  # frame is resized (to smaller size), to gain some speed
        
        elif picamera_test:                                       # case picamera_test is True:
            w = width                                             # widht is assigned to w
            h = height                                            # height is assigned to h
        
        oneframe = True                                           # flag for a single frame analysis at the time
        rawCapture.truncate(0)                                    # empties the array in between each camera's capture      

        return frame, w, h





            
def frame_cropping(frame, width, height, x_l, x_r, y_u, y_b):
    """Frame cropping, to prevent reading the back cube side and to increase overal speed.
    Due to short camera distance from the cube, all the PiCamera sensor area is used,
    therefore pixels reduction is beneficial ro reduce overall memory load.
    For proper setting of these parameters, it is convenient to temporary skip the frame_warping:
    uncomment first row at frame_warping function."""
    
#     uncomment below row (return frame, width, height) to prevent the image cropping
#     this is useful for initial camera positioning (angle) on the top_cover
#     return frame, width, height


#     x_l = 0 #(AF 60)     # pixels to remove from the frame left side, to reduce memory load 
#     x_r = 0 #(AF 80)     # pixels to remove from the frame right side, to reduce memory load
#     y_u = 0 #(AF 40)     # pixels to remove from the frame top side, to reduce memory load
#     y_b = 0 #(AF 110)    # pixels to remove from the frame bottom side, to reduce memory load
    
    frame = frame[y_u: height-y_b , x_l: width-x_r]   # frame is sliced
    w = width - x_l - x_r                             # sliced frame width
    h = height - y_u - y_b                            # sliced frame height
    
    return frame, w, h







def warp_image(frame, w, h, w_f, w_s):
    """ Warp the image to remove perspective and simulate a top like view.
    This because PiCamera is at an angle with reference to the top cube face.
    This allows to analyse the facelets contours (square like, area, etc) in a more precise way.
    This also allows a much nicer cube faces collage."""
    
#     NOTE: uncomment below row to remove the image warping, useful for initial setting the camera frame cropping (frame_cropping)
#     return frame, w, h
    
    if cv_wow:                        # case the cv image analysis plot is set true
        global pre_warp, after_warp   # global variable for the frame content, before and after warping
        pre_warp = frame              # frame is assigned to the pre_warp variable
        ww = w                        # frame width before warping is assigned to a local variable
        hh = h                        # frame height before warping is assigned to a local variable
    
    grid_vertices = np.float32([[0,0], [h,0], [h,w], [0,w]])  # original frame vertices

#     w_f = 7           #(AF 7) fractional frame width part to be 'removed' on top left and right of the frame    
    d_x = int(w/w_f)            # pixels to 'remove' on top left and top righ sides of frame, to warp the image
    straight = 1+d_x/h          # corrects the cube face deformation 

    warped_vertices = np.float32([[d_x,0], [h,0], [int(straight*h),w], [-d_x, w]])  # frame coordinates for the transformation matrix
    matrix = cv2.getPerspectiveTransform(warped_vertices, grid_vertices)            # compute perspective matrix

    # do perspective transformation, by adding black pixels where needed
    frame = cv2.warpPerspective(frame, matrix, (max(w,h), max(w,h)), cv2.INTER_LINEAR, cv2.BORDER_CONSTANT, borderValue=(0,0,0))
    
#     w_s = 1.5                   #(AF 1.5)  # Fractional part of the warping portion to be used as slicing from frame bottom
    frame = frame[: -d_x, :-int(d_x/w_s)]   # frame slicing to remove part of the added (black) pixels on the right frame side 
    h, w = frame.shape[:2]                  # new frame height and width
    
    if cv_wow:                                           # case the cv image analysis plot is set true
        pre_warp, _, _ = frame_resize(pre_warp, ww, hh)  # re-sized frame is assigned to the pre_warp global variable
        after_warp, _, _ = frame_resize(frame, w, h)     # re-sized frame is assigned to the after_warp global variable
    
    return frame, w, h







def frame_resize(frame_w, ww, hh, scale=0.8):        
    """ Re-sizes the image after the cropping and warping steps, by a scaling factor.
    This is useful to lower the amount of handled data for the facelects and color detection."""
    
    ww = int(ww * scale)                  # new frame width
    hh = int(hh * scale)                  # new frame height
    
    if Rpi_ZeroW:                         # case Rpi_ZeroW is True (armv6 processor)
        interp_method = cv2.INTER_LINEAR  # bilinear interpolation method (prevents crashing with armv6 processor))
    else:                                 # case Rpi_ZeroW is False (not an armv6 processor)
        interp_method = cv2.INTER_AREA    # interpolation method resamples using pizel area relation

    frame_s = cv2.resize(frame_w, (ww, hh), interpolation = interp_method)  # resized frame
    return frame_s, ww, hh







def edge_analysis(frame, w, h):
    """ Image analysis that returns a black & white image, based on the colors borders.
        From 30th July 2022 differentiated the analysis for cube with /withouth the black frame around the facelets."""
    
    if cv_wow and screen:                                    # case screen and cv_wow variables are set true on __main__
        global gray, blurred, canny, dilated, eroded         # images are set as global variable

    gray = cv2.cvtColor(frame, cv2.COLOR_BGR2GRAY)           # from BGR color space to gray scale
    
    if frameless_cube == 'false':                            # case the cube has black frame around the facelets
        blurred = cv2.GaussianBlur(gray, (5, 5), 0)          # low pass gaussian filter, with a 5x5 gaussian filter (9x9 until 30th July 2022)
        canny = cv2.Canny(blurred, 10, 30)                   # single pixel edges, with intensity gradient range 10 to 30
        kernel = np.ones((5,5), np.uint8)                    # kernel of 5x5 pixels for the dilate transformation
        dilated = cv2.dilate(canny, kernel, iterations = 4)  # higher "iterations" is overall faster
        kernel = np.ones((3,3), np.uint8)                    # smaller kernel is used for the erosion
        eroded = cv2.erode(dilated, kernel, iterations = 2)  # smaller "iterations" keeps the contour apart from the edges
    
    elif frameless_cube == 'true':                           # case the cube is a frameless cube
        blurred = cv2.bilateralFilter(gray, 3, 80, 80)       # low pass bilateral filter, to de-noise while safegarding edges
        canny = cv2.Canny(blurred, 4, 25)                    # single pixel edges, with intensity gradient range 4 to 25
        kernel = np.ones((7,7), np.uint8)                    # kernel of 7x7 pixels for the dilate transformation
        dilated = cv2.dilate(canny, kernel, iterations = 4)  # higher "iterations" is overall faster
        kernel = np.ones((5,5), np.uint8)                    # smaller kernel is used for the erosion
        eroded = cv2.erode(dilated, kernel, iterations = 1)  # smaller "iterations" keeps the contour apart from the edges
    
    # note: when frameless_cube == 'auto' the cube detection takes slightly longer
    elif frameless_cube == 'auto':                           # case for cubes with and without the black frame around the facelets
        blurred = cv2.GaussianBlur(gray, (5, 5), 0)          # low pass gaussian filter, with a 5x5 gaussian filter
        canny_01 = cv2.Canny(blurred, 10, 30)                # single pixel edges, with intensity gradient range 10 to 30
        blurred = cv2.bilateralFilter(gray,4, 200, 200)  # 3, 80, 80)        # low pass bilateral filter, to de-noise while safegarding edges
        canny_02 = cv2.Canny(blurred, 4, 25)                 # single pixel edges, with intensity gradient range 4 to 25
        canny = cv2.bitwise_or(canny_01, canny_02, mask = None) # canny image, by (OR) combining those generated with parameters with and without frames
        kernel = np.ones((7,7), np.uint8)                    # kernel of 7x75 pixels for the dilate transformation
        dilated = cv2.dilate(canny, kernel, iterations = 3)  # higher "iterations" is overall faster
        kernel = np.ones((3,3), np.uint8)                    # smaller kernel is used for the erosion
        eroded = cv2.erode(dilated, kernel, iterations = 2)  # smaller "iterations" keeps the contour apart from the edges
    
############ visual check edge detection #############
#     cv2.imshow("Gray", gray)           # gray is shown, on a window called Gray
#     cv2.imshow("blurred", blurred)     # blurred is shown, on a window called Blurred
#     cv2.imshow("Canny", canny)         # canny is shown, on a window called Canny
#     cv2.imshow("Dilated", dilated)     # dilated is shown, on a window called Dilated
#     cv2.imshow("Eroded", eroded)       # eroded is shown, on a window called Eroded
######################################################
    
    return eroded, w, h







def show_cv_wow(cube, time=2000):
    """ shows how the image from the camera is altered to detect the facelets.
        Also possible to set a boolean to save those images."""
    
    gap_w = 80       # horizontal gap (width) for all windows from 'Pre_warp' window
    gap_h = 100      # vertical gap (height), above first row of images and between the two rows of windows
    
    # note: for precise window position, after windows name at cv2.namedWindow, the parameter cv2.WINDOW_NORMAL  
    # should be used instead of the cv2.WINDOW_RESIZE (default), but image quality on screen changes too much....
    cv2.namedWindow('Pre_warp')                      # create the Pre_warp window
    cv2.moveWindow('Pre_warp', w, gap_h)             # move the Pre_warp window to coordinate
    cv2.namedWindow('After_warp')                    # create the Frame window
    cv2.moveWindow('After_warp', 2*w+gap_w, gap_h)   # move the Frame window to coordinate
    cv2.namedWindow('Gray')                          # create the Gray window
    cv2.moveWindow('Gray', 3*w+gap_w, gap_h)         # move the Gray window to coordinate
    cv2.namedWindow('blurred')                       # create the Blurred window
    cv2.moveWindow('blurred', 4*w+gap_w, gap_h)      # move the Blurred window to coordinate
    cv2.namedWindow('Canny')                         # create the Canny window
    cv2.moveWindow('Canny', w+gap_w, h+2*gap_h)      # move the Canny window to coordinate
    cv2.namedWindow('Dilated')                       # create the Dilated window
    cv2.moveWindow('Dilated', 2*w+gap_w, h+2*gap_h)  # move the Dilated window to coordinate
    cv2.namedWindow('Eroded')                        # create the Eroded window
    cv2.moveWindow('Eroded', 3*w+gap_w, h+2*gap_h)   # move the Eroded window to coordinate
    cv2.namedWindow('Cube')                          # create the Cube window
    cv2.moveWindow('Cube', 4*w+gap_w, h+2*gap_h)     # move the Cube window to coordinate
    
    cv2.imshow("Pre_warp", pre_warp)                 # pre-warp is shown, on a window called Pre_warp
    cv2.imshow("After_warp", after_warp)             # after_warp is shown, on a window called After_warp
    cv2.imshow("Gray", gray)                         # gray is shown, on a window called Gray
    cv2.imshow("blurred", blurred)                   # blurred is shown, on a window called Blurred
    cv2.imshow("Canny", canny)                       # canny is shown, on a window called Canny
    cv2.imshow("Dilated", dilated)                   # dilated is shown, on a window called Dilated
    cv2.imshow("Eroded", eroded)                     # eroded is shown, on a window called Eroded
    cv2.imshow("Cube", cube)                         # cube is shown, on a window called Cube
    
    if side == 1:                   # case the first cube side is under analysis 
        cv2.waitKey(time + 4000)    # all the openCV windows are showed, with an extra time on first cube side
    else:                           # case the cube side under analysis is not the first side
        cv2.waitKey(time)           # all the openCV windows are showed
    
    save_images = False                                         # boolean to enable/disable saving cv_wow images
    folder = pathlib.Path().resolve()                           # active folder (should be home/pi/cube)  
    if save_images:                                             # case the save_image is True
        folder = os.path.join(folder,'cv_wow_pictures')         # folder to store the cv_wow pictures
        if not os.path.exists(folder):                          # if case the folder does not exist
            os.makedirs(folder)                                 # folder is made if it doesn't exist
        datetime = dt.datetime.now().strftime('%Y%m%d_%H%M%S')  # date_time variable is assigned, for file name
        for i, image in enumerate(('Pre_warp', 'After_warp', 'Gray', 'Blurred', 'Canny', 'Dilated', 'Eroded', 'Cube')):
            if side == 1 and i == 0:                                       # case for first image to save
                print('\n\n##########################################')    # feedback is printed to the terminal
                print('###   saving 48 cv_wow pictures  !!!  ####')        # feedback is printed to the terminal
                print('##########################################\n\n')    # feedback is printed to the terminal
            fname = datetime + '_Side'+ str(side) + '_' + str(i) + '_'+ image + '.png'  # filename constructor
            fname = os.path.join(folder, fname)         # folder+filename for the cube data
            if image == 'Pre_warp':                     # case the image equals to Pre_warp
                cv2.imwrite(fname, pre_warp)            # pre_warp image is saved
            elif image == 'After_warp':                 # case the image equals to Frame
                cv2.imwrite(fname, after_warp)          # frameimage is saved
            elif image == 'Gray':                       # case the image equals to Gray
                cv2.imwrite(fname, gray)                # gray image is saved
            elif image == 'Blurred':                    # case the image equals to Blurred
                cv2.imwrite(fname, blurred)             # blurred image is saved
            elif image == 'Canny':                      # case the image equals to Canny
                cv2.imwrite(fname, canny)               # canny image is saved
            elif image == 'Dilated':                    # case the image equals to Dilated
                cv2.imwrite(fname, dilated)             # dilated image is saved
            elif image == 'Eroded':                     # case the image equals to Eroded
                cv2.imwrite(fname, eroded)              # eroded image is saved
            elif image == 'Cube':                       # case the image equals to Cube
                cv2.imwrite(fname, cube)                # cube image is saved
            else:                                       # case the does not match proposed strings
                print('error in image list')            # feedback is printed to the terminal








def square_check(data):  
    """Sanity check if a contour has a square like shape; Argument is a contour
    Calculates quadrilateral's edge delta lenght: [(max edge - min edge)/average of sides length]
    Calculates the ratio between the 2 diagonals (rhonbus axes): min diagonal / max diagonal
    These parameter are later used to verify if the contour can be considered like a square.
    A perfect square will have edge_delta==0 and axes_delta==1."""
    
    edges=[]                    # list of the 4 edges of the quadrilateral
    axes=[]                     # List of axes of symmetry length of the rhombus
    for i in range(len(data)):  # iteration over the contour vertices 
        j = i + 1               # following vertex
        if i==3:                # case the current iteration is on vertex 
            j=0                 # following vertex is set as the first one
        edges.append(math.sqrt((data[j][0]-data[i][0])**2 + (data[j][1]-data[i][1])**2))  # list of the 4 edge's length
        edge_delta = (max(edges)-min(edges))*4/sum(edges)                                 # max side delta over the mean
    
    for i in range(2):          # iteration over 2 (diagonals)
        j = i + 2               # following vertices is the after the next 
        axes.append(math.sqrt((data[j][0]-data[i][0])**2 + (data[j][1]-data[i][1])**2))  # list of the 2 rhobus axes
        axes_delta = min(axes)/max(axes)    # axes delta is the division of the smallest over the largest
    
    return edge_delta, axes_delta







def distance_deviation(data, delta=0.3):
    """ Checks whether the distances between the 9 contours centers are within a pre-defined deviation from the median
    This is a sanity check if all the 9 facelet are compatible with a 3x3 square array shape
    Aim of this funtion is to exclude contours generated outside the cube, on eventual square like shapes
    detected by the camera at the cube background.
    The approach checks indipendently the 6 horizontal distances from the contours center, from the 6 vertical ones.
    Considering the cube can have a certain tilting angle (inclination), Pitagora theorem is used
    Function return a list with the index of the countours to be removed, if excess of distance, from the
    list of contours considered being potential facelets.
    -------------
    | 0 | 1 | 2 |
    -------------
    | 3 | 4 | 5 |
    -------------
    | 6 | 7 | 8 |
    -------------    
    """
    
    d_to_exclude = []        # list of the contour index to be removed, due to excess of distance deviation
    distance_list_h = []     # list of the horizontal distance, of each contour from the median one
    distance_list_v = []     # list of the vertical distance, of each contour from the median one
    
    points_h=[1,2,4,5,7,8]   # coordinates, defining a segment with a previous coordinate,for 6 'horizontal' distances
    for i in points_h:       # iteration over the 6 coordinates
        j=i-1                # the other coordinate used for the segment length
        # horizontal distance between the contours centers
        dist=math.sqrt((data[i]['cx']-data[j]['cx'])**2 + (data[i]['cy']-data[j]['cy'])**2)
        distance_list_h.append(dist)  # list with horizontal distance between the contours centers

    points_v=[3,4,5,6,7,8]   # coordinates, defining a segment with a previous coordinate,for 6 'vertical' distances
    for i in points_v:       # iteration over the 6 coordinates
        k=i-3                # the other coordinate used for the segment length
        # vertical distance between the contours centers
        dist=math.sqrt((data[i]['cx']-data[k]['cx'])**2 + (data[i]['cy']-data[k]['cy'])**2)
        distance_list_v.append(dist)  # list with vertical distance between the contours centers

    dist_median_h = median(distance_list_h)                           # median value for horiz distances
    for i in range(len(distance_list_h)):                             # iteration over the list with the (expected 6) horizontal distance
        delta_dist_h=(distance_list_h[i]-dist_median_h)/dist_median_h # deviation in horiz distance
        if delta_dist_h > delta:                                      # filter if horiz deviation > threshold
            d_to_exclude.append(i) # list with contours indexto exlude, due excess on horiz deviation from median

    dist_median_v = median(distance_list_v)                           # median value for vert distances
    for i in range(len(distance_list_v)):                             # iteration over the list with the (expected 6) vertical distance
        delta_dist_v=(distance_list_v[i]-dist_median_v)/dist_median_v # deviation in vert distance
        if delta_dist_v > delta and i not in d_to_exclude: # filter if horiz deviation > threshold
            d_to_exclude.append(i)  # list with contours indexto exlude, due excess on vert deviation from median
    
    return d_to_exclude






def read_facelets(frame, w, h):
    """ Function that uses cv2 to retrieve contours, from an image (called frame in this case)
    Contours are searched on the 'eroded edges' frame copy
    ROI (Region Of Interest) restricts the image to where the cube images really is

    Notes on 'cv2 find contours'
    Contour's tree is used (cv2.RETR_TREE), to identify children contours (contours within other contrours)
    Approximation (v2.CHAIN_APPROX_SIMPLE) reduces the amount of pixel down to only vertes."""
    
    global prev_side
 
    if side!=prev_side:                           # case the current side differs from the previous side
        if debug:                                 # case debug variable is set true on __main__
            print()                               # print an empty line to the terminal
        print(f'Reading side {sides[side]}')      # feedback is printed to the terminal
        prev_side=side                            # current side is assigned to previous side variable

    image, w, h = edge_analysis(frame, w, h)      # image edges analysis is applied to the frame
    
    (contours, hierarchy) = cv2.findContours(image, cv2.RETR_TREE, cv2.CHAIN_APPROX_SIMPLE)  # contours are searched on the image
#     (contours, hierarchy) = cv2.findContours(image.copy(), cv2.RETR_TREE, cv2.CHAIN_APPROX_SIMPLE)  # contours are searched on the image copy
    
    return (contours, hierarchy)                  # contours are returned
    







def get_approx_contours(component):
    """ Function that simplifies contours (from: https://docs.opencv.org/4.5.3/dd/d49/tutorial_py_contour_features.html)
    Argument is a contour, having at least 4 vertex (contours with less than 4 vertex were previously filtered out)
    Returns approximated contours, having 4 vertex.""" 
    
    contour = component[0]
    hierarchy = component[1][2]
    peri = cv2.arcLength(contour, True)
    contour_convex = cv2.convexHull(contour, False)
    contour = cv2.approxPolyDP(contour_convex, 0.1*peri, True)
    
    return contour, hierarchy, len(contour)







def get_facelets(facelets, frame, contour, hierarchy):
    """ Contours are analyzed in order to detect the cube's facelets; Argument are simplified contours.
    Returns contours having square characteristics
    
    [parameter to be square like: Area within limits, limited egde lenght deviation, limited diagonals lenght deviation
    (to prevent rhonbus), limited area variation between the 9 facelets].
    This function is called on each of the cube sides, therefore the return relates to the face under analysis.""" 
    
    min_area = int(0.08*(w*h)/9)    #(AF int(0.08*(w*h)/9))  # min area limit for a single facelet's contour
    max_area = 6*min_area           #(AF 6*min_area)         # max area limit for a single facelet's contour       

#     square_ratio=1       #(AF 1)    # it is like a square when min side/max side < square_ratio (0==perfect square, 1 is rather permissive)
#     rhombus_ratio=0.3    #(AF 0.3)  # considered like a square when diagonal1/diagonal2 > rhombus_ratio (1==perfect, 0.3 is rather permissive)
         
    area = cv2.contourArea(contour)                                       # area of each passed contour is retrieved
    
    if min_area < area < max_area:                                        # filter out too small and too large contours (areas)
        contour_squeeze = np.squeeze(contour)                             # flattens out the list of list used by contours
        edges_delta, axes_ratio = square_check(contour_squeeze)           # sanity check on square and ronbhus shapes
        if edges_delta < square_ratio and axes_ratio > rhombus_ratio:     # check if the contour looks like a square
            cont, in_cont, out_cont = order_4points(contour_squeeze, w, h)  # vertex of each contour are ordered CW from top left
            contour_tmp = [cont]                                          # list is made with the ordered detected contour
            frame = cv2.drawContours(frame, contour_tmp, -1, (255, 255, 255), 1)  # a white polyline is drawn on the contour (1 px thickness)
            if debug:                                                     # case debug variable is set true on __main__
                # a white circle is drawn on the 1st vertex (top left), as visual check of proper vertices ordering
                frame = cv2.circle(frame, (contour_tmp[0][0][0],contour_tmp[0][0][1]), 5, (255, 255, 255), -1)
            contour_tmp = [out_cont]                                      # list is made with the ordered outer contour
            frame = cv2.drawContours(frame, contour_tmp, -1, (0, 0, 0), 1)  # a black polyline is drawn on the outer contour (1 px thickness)
            
            M = cv2.moments(contour)                    # the shape moment (center) of the contour is retrieved
            if M['m00']:                                # compute the center of the contour   
                cX = int(M['m10'] / M['m00'])           # X value for the contour center
                cY = int(M['m01'] / M['m00'])           # Y value for the contour center
            
            tmp = {'area': area, 'cx': cX, 'cy': cY, 'contour': contour, 'cont_ordered':in_cont}  # dict with relevant contour info
            facelets.append(tmp)                        # list with the dictionary of the potential facelets contrours
                                
            if len(facelets)>=5:                        # case there are at least 5 potential contours
                a_to_exclude = area_deviation(facelets, min_area, max_area) # function that analyzes facelets area, and list those with high dev from median
                if len(a_to_exclude)>=1:                # case when there are facelets to be excluded, due to too different area from median one
                    a_to_exclude.sort(reverse=True)     # list order is reversed, making easy easy to remove
                    for i in a_to_exclude:              # contour deviating too much on area are removed from list of potential facelets
                        facelets.pop(i)                 # contour deviating too much on area are removed from list of potential facelets
                else:                                   # case there are not facelets to be excluded, due to large area deviation
                    if frameless_cube != 'false':       # case the cube status reading is for frameless cubes or auto (with and without frames)
                        facelets, frame = estimate_facelets(facelets,frame, w, h)  # calls the function to estimate the remaining facelets                                 
    
    return facelets, frame   # list of potential facelet's contour is returned







def facelet_grid_pos(x, y):
    """returns the face facelet number, based on the coordinates of the contour center, and other parameters.
        This is used to map in which facelets a contour has been detected, and which not."""
    
    # Below dict has the face facelets number as value; keys are facelet coordinate expressed as string combination of column and row
    facelet_number = {'11':0, '21':1, '31':2,
                      '12':3, '22':4, '32':5,
                      '13':6, '23':7, '33':8}
    
    facelet = str(x) + str(y)                 # facelet string combining column (x) and row (y) of the facelet
    if facelet in facelet_number:             # case the facelecet is in the dict
        return facelet_number[facelet]        # facelet number is returned







def estimate_facelets(facelets, frame, w, h):
    """Estimates the remaing facelets location, when there are at least 5 detected facelets.
        This function is interrupted if one row or column is fully empty; In this way the cube width and height
        is well known, enabling a good estimation for the missed facelets position.
        This function is called when the frameless_cube is set true or auto.
        This function is not called when the the setting is exclusively set for cubes with black frame around the facelets.
    
    
                x_1     x_2     x_3              X
           --|----------------------------------->
             |       |       |       |
        y_1  |   1   |   2   |   3   |   row 1
             |       |       |       |
             |-----------------------
             |       |       |       |
        y_2  |   4   |   5   |   6   |   row 2
             |       |       |       |
             |----------------------- 
             |       |       |       |
        y_3  |   7   |   8   |   9   |   row 3
             |       |       |       |
             |-----------------------
             |
             | clmn1   clmn2   clmn3
             |
             |
           Y v
         
    """
    
    
    cont_x = []                                # empty list to fill with contours centers x coordinates
    cont_y = []                                # empty list to fill with contours centers y coordinates
    cont_area = []                             # empty list to fill with contours areas
    facelets_detected = len(facelets)          # number of facelets alerady detected
    
    for i in range(facelets_detected):         # iteration over the quantity of facelets already detected
        cont_x.append(facelets[i]['cx'])       # all the contours centers x coordinates are listed
        cont_y.append(facelets[i]['cy'])       # all the contours centers y coordinates are listed
        cont_area.append(facelets[i]['area'])  # all the contours areas are listed
    
    med_a = int(median(cont_area))             # median area for the facelets in function argument
    
    cx = cont_x.copy()         # list copy of contours centers x coordinates
    cy = cont_y.copy()         # list copy of contours centers y coordinates
    cont_x.sort()              # sorted list with contours centers x coordinates
    cont_y.sort()              # sorted list with contours centers y coordinates
    
    x_1 = []                   # empty list to fill with x coordinates of first column (smaller x)
    x_2 = []                   # empty list to fill with x coordinates of second column (medium x)
    x_3 = []                   # empty list to fill with x coordinates of third column (larger x)
    y_1 = []                   # empty list to fill with y coordinates of first row (smaller y)
    y_2 = []                   # empty list to fill with y coordinates of second row (medium y)
    y_3 = []                   # empty list to fill with y coordinates of third row (larger y)

    x_low = cont_x[0]          # smaller x coordinate of facelets countours is assigned to the variable x_low
    x_high = cont_x[-1]        # bigger x coordinate of facelets countours is assigned to the variable x_high
    y_low = cont_y[0]          # smaller y coordinate of facelets countours is assigned to the variable y_low
    y_high = cont_y[-1]        # bigger y coordinate of facelets countours is assigned to the variable y_high 
    
    dist = int(max(x_high-x_low, y_high-y_low)/4) # facelets separation distance from min/max detected contours centers
    
    x_1.append(x_low)          # smaller x coordinate of facelets countours is appended to the first column list
    y_1.append(y_low)          # smaller y coordinate of facelets countours is appended to the first row list
    
    for i in range(1, facelets_detected):                              # iteration on detected facelets contours
        if x_low <= cont_x[i] and cont_x[i] < x_low + dist:            # case the contour center x coordinate is "small"
            x_1.append(cont_x[i])                                      # contour x coordinate is appended to the of first column list (small x)
        elif x_low + dist <= cont_x[i] and cont_x[i] < x_high - dist:  # case the contour center x coordinate is "medium"
            x_2.append(cont_x[i])                                      # contour x coordinate is appended to the of second column list (medium x)
        else:                                                          # case the contour center x coordinate is "large"
            x_3.append(cont_x[i])                                      # contour x coordinate is appended to the of third column list (large x)
        
        if y_low <= cont_y[i] and cont_y[i] < y_low + dist:            # case the contour center y coordinate is "small"
            y_1.append(cont_y[i])                                      # contour y coordinate is appended to the of first row list (small y)
        elif y_low + dist <= cont_y[i] and cont_y[i] < y_high - dist:  # case the contour center y coordinate is "medium"
            y_2.append(cont_y[i])                                      # contour y coordinate is appended to the of second row list (medium y)
        else:                                                          # case the contour center y coordinate is "large"
            y_3.append(cont_y[i])                                      # contour y coordinate is appended to the of third row list (large y)
    
    if len(x_1)==0 or len(x_2)==0 or len(x_3)==0 or len(y_1)==0 or len(y_2)==0 or len(y_3)==0: # case one or more of the six lists are empty
        return facelets, frame                                                # function returns the already detected facelets
    
    else:                                      # case no one of the six lists is empty
        x1_avg = int(sum(x_1)/len(x_1))        # average x coordinate for the contours on first column (small x)
        x2_avg = int(sum(x_2)/len(x_2))        # average x coordinate for the contours on second column (medium x)
        x3_avg = int(sum(x_3)/len(x_3))        # average x coordinate for the contours on third column (large x)
        y1_avg = int(sum(y_1)/len(y_1))        # average y coordinate for the contours on first row (small y)
        y2_avg = int(sum(y_2)/len(y_2))        # average y coordinate for the contours on second row (medium y)
        y3_avg = int(sum(y_3)/len(y_3))        # average y coordinate for the contours on third row (large y)
    
    dist = int((x_high - x_low + y_high - y_low)/8)   # facelets separation distance from min/max detected contours centers
    detected = []                                     # list for the column row of the face grid
    for i in range(facelets_detected):                # iteration over the detected facelets
        if cx[i]<x_low+dist:                          # case the facelet contour center x coordinate is on first grid column
            x=1                                       # 1 (as column 1) is assigned
        elif cx[i]>x_low+dist and cx[i]<x_high-dist:  # case the facelet contour center x coordinate is on second grid column
            x=2                                       # 2 (as column 2) is assigned
        elif cx[i]>x_high-dist:                       # case the facelet contour center x coordinate is on third grid column
            x=3                                       # 3 (as column 3) is assigned
        if cy[i]<y_low+dist:                          # case the facelet contour center x coordinate is on first grid row                          
            y=1                                       # 1 (as row 1) is assigned
        elif cy[i]>y_low+dist and cy[i]<y_high-dist:  # case the facelet contour center x coordinate is on second grid row
            y=2                                       # 2 (as row 2) is assigned
        elif cy[i]>y_high-dist:                       # case the facelet contour center x coordinate is on third grid row
            y=3                                       # 3 (as row 3) is assigned
        detected.append(facelet_grid_pos(x, y))       # list with facelet number is populated
    
    s = set(detected)                                        # list with detected facelets numbers is transformed to set
    missed = [x for x in (0,1,2,3,4,5,6,7,8) if x not in s]  # list with missed facelets numbers
    
    est = []                                  # list for xy coordinates for the estimated facelet center locations
    for facelet in missed:                    # iteration over the missed facelets numbers
        if facelet == 0:                      # case the missed facelet is 0
            est.append((x1_avg, y1_avg))      # average xy coordinates for column 1 and row 1 are appended
        elif facelet == 1:                    # case the missed facelet is 1
            est.append((x2_avg, y1_avg))      # average xy coordinatees for column 2 and row 1 are appended
        elif facelet == 2:                    # case the missed facelet is 2
            est.append((x3_avg, y1_avg))      # average xy coordinats for column 3 and row 1 are appended
        elif facelet == 3:                    # case the missed facelet is 3
            est.append((x1_avg, y2_avg))      # average xy coordinates for column 1 and row 2 are appended
        elif facelet == 4:                    # case the missed facelet is 4
            est.append((x2_avg, y2_avg))      # average xy coordinates for column 2 and row 2 are appended
        elif facelet == 5:                    # case the missed facelet is 5
            est.append((x3_avg, y2_avg))      # average xy coordinates for column 3 and row 2 are appended
        elif facelet == 6:                    # case the missed facelet is 6
            est.append((x1_avg, y3_avg))      # average xy coordinates for column 1 and row 3 are appended
        elif facelet == 7:                    # case the missed facelet is 7
            est.append((x2_avg, y3_avg))      # average xy coordinates for column 2 and row 3 are appended
        elif facelet == 8:                    # case the missed facelet is 8
            est.append((x3_avg, y3_avg))      # average xy coordinates for column 3 and row 3 are appended
        else:                                 # case that shouldn't exist
            print("error on estimating the missed facelets")  # feedback is printed to the terminal

    semi_side = int(0.85*dist/2)                              # half side dimension for the estimated contour square
    for i in range(len(missed)):                              # iteration over the missed facelets
        tl = [est[i][0] - semi_side, est[i][1] - semi_side]   # top left contour coordinate, calculated from the estimated contour center point
        tr = [est[i][0] + semi_side, est[i][1] - semi_side]   # top right contour coordinate, calculated from the estimated contour center point
        br = [est[i][0] + semi_side, est[i][1] + semi_side]   # bottom right contour coordinate, calculated from the estimated contour center point
        bl = [est[i][0] - semi_side, est[i][1] + semi_side]   # bottom left contour coordinate, calculated from the estimated contour center point
        pts=np.array([tl, tr, br, bl], dtype="int32")         # estimated contour coordinates      
        
        gap=5                                  # pixels gap
        tl[0]=max(tl[0]-gap,0)                 # top left x coordinate, shifted toward the contour outer side
        tl[1]=max(tl[1]-gap,0)                 # top left y coordinate, shifted toward the contour outer side
        tr[0]=min(tr[0]+gap,w)                 # top right x coordinate, shifted toward the contour outer side
        tr[1]=max(tr[1]-gap,0)                 # top right y coordinate, shifted toward the contour outer side
        br[0]=min(br[0]+gap,w)                 # bottom right x coordinate, shifted toward the contour outer side
        br[1]=min(br[1]+gap,h)                 # bottom right y coordinate, shifted toward the contour outer side
        bl[0]=max(bl[0]-gap,0)                 # bottom left x coordinate, shifted toward the contour outer side
        bl[1]=min(bl[1]+gap,h)                 # bottom left y coordinate, shifted toward the contour outer side
        outer_pts=np.array([tl, tr, br, bl], dtype="int32")     # estimated contour coordinates, sligtly shifted toward the contour outer side
        
        contour_tmp = [pts]                    # list is made with the ordered outer contour
        frame = cv2.drawContours(frame, contour_tmp, -1, (0, 0, 0), 1)        # a black polyline is drawn on the contour (1 px thickness)
        contour_tmp = [outer_pts]              # list is made with the ordered outer contour
        frame = cv2.drawContours(frame, contour_tmp, -1, (255, 255, 255), 1)  # a white polyline is drawn on the outer contour (1 px thickness)

        tmp = {'area': med_a, 'cx': est[i][0], 'cy': est[i][1], 'contour': pts, 'cont_ordered':pts} # dict with relevant contour info
        facelets.append(tmp)                   # estimated facelets relevant info are appended to the detected facelets list
    
    if screen and debug and frameless_cube!=False:                             # case there is a connected screen, debug and Frameless_cube not False
        cv2.line(frame, (x_low+dist,0), (x_low+dist,h), (255, 255, 255), 2)    # vertical line is drawn between first and second row of facelets
        cv2.line(frame, (x_high-dist,0), (x_high-dist,h), (255, 255, 255), 2)  # vertical line is drawn between second and third row of facelets
        cv2.line(frame, (0,y_low+dist), (w,y_low+dist), (255, 255, 255), 2)    # horizontal line is drawn between first and second column of facelets
        cv2.line(frame, (0,y_high-dist), (w,y_high-dist), (255, 255, 255), 2)  # horizontal line is drawn between second and third column of facelets
        
    return facelets, frame     # detected facelets combined with estimated facelets







def get_facelets_fcs(facelets, frame):
    """This function points to fix coordinates at the cube face image, to retrieve the color.
        Dummy contours are made, to visualize them on screen, or saved picture_collage, when debug is true."""
    
    if debug:
        print("\nCalled the fix_coordinate_approach")
        
    c = f_coordinates                          # f_coordinates assigned to a local very short variable name
    
    # x and y distance between the facelets coordinates
    x_dist = (c[2]-c[0] + c[4]-c[2] + c[8]-c[6] + c[10]-c[8] + c[14]-c[12] + c[16]-c[14])/6
    y_dist = (c[7]-c[1] + c[9]-c[3] + c[11]-c[5] + c[13]-c[7] + c[15]-c[9] + c[17]-c[11])/6
    
    s_side_x = int(round(0.6*x_dist/2,0))      # half side dimension, along x, for the estimated contour square
    s_side_y = int(round(0.6*y_dist/2,0))      # half side dimension, along y, for the estimated contour square                    
    
    area = s_side_x*s_side_y*4                 # estimated area
    for i in range(0,18,2):                    # iteration over the 9 facelets
        tl = [c[i] - s_side_x, c[i+1] - s_side_y]  # top left contour coordinate, calculated from the fix coordinate center point
        tr = [c[i] + s_side_x, c[i+1] - s_side_y]  # top right contour coordinate, calculated from the fix coordinate center point
        br = [c[i] + s_side_x, c[i+1] + s_side_y]  # bottom right contour coordinate, calculated from the fix coordinate center point
        bl = [c[i] - s_side_x, c[i+1] + s_side_y]  # bottom left contour coordinate, calculated from the fix coordinate center point
        pts=np.array([tl, tr, br, bl], dtype="int32")  # estimated contour coordinates      
        
        gap=3                                  # pixels gap
        tl[0]=max(tl[0]-gap,0)                 # top left x coordinate, shifted toward the contour outer side
        tl[1]=max(tl[1]-gap,0)                 # top left y coordinate, shifted toward the contour outer side
        tr[0]=min(tr[0]+gap,w)                 # top right x coordinate, shifted toward the contour outer side
        tr[1]=max(tr[1]-gap,0)                 # top right y coordinate, shifted toward the contour outer side
        br[0]=min(br[0]+gap,w)                 # bottom right x coordinate, shifted toward the contour outer side
        br[1]=min(br[1]+gap,h)                 # bottom right y coordinate, shifted toward the contour outer side
        bl[0]=max(bl[0]-gap,0)                 # bottom left x coordinate, shifted toward the contour outer side
        bl[1]=min(bl[1]+gap,h)                 # bottom left y coordinate, shifted toward the contour outer side
        outer_pts=np.array([tl, tr, br, bl], dtype="int32")     # estimated contour coordinates, sligtly shifted toward the contour outer side
        
        contour_tmp = [pts]                    # list is made with the ordered outer contour
        frame = cv2.drawContours(frame, contour_tmp, -1, (0, 0, 0), 1)        # a black polyline is drawn on the contour (1 px thickness)
        contour_tmp = [outer_pts]              # list is made with the ordered outer contour
        frame = cv2.drawContours(frame, contour_tmp, -1, (255, 255, 255), 1)  # a white polyline is drawn on the outer contour (1 px thickness)

        tmp = {'area': area, 'cx': c[i], 'cy': c[i+1], 'contour':pts, 'cont_ordered':pts} # dict with relevant contour info
        facelets.append(tmp)                   # estimated facelets relevant info are appended to the detected facelets list
    
    return facelets, frame     # facelets info, based on fix coordinates, are returned







def area_deviation(data, min_area, max_area):
    """ Checks whether the areas of 9 facelets are within a pre-defined deviation from the median one
    This function is called when there are a pre-defined amount of potential facelet contours
    Argument is a list of dictionary, wherein the area is one of the dict values
    Returns a list of facelets (index) to be removed from the potential facelets, having area deviating
    too much from the median one."""

    
    to_exclude = []                  # list of the contours index to be removed, due to excess of their area deviation
#     delta_area_limit = 0.7            #(AF 0.7)   # 70% of area deviation from the median is set as threshold (quite permissive)
    area_list = []                   # list to store the contour areas
    
    for i in range(len(data)):
        area_list.append(data[i]['area'])                       # all the contour areas are listed
#         print("contours areas detected:",area_list)             # feedback is printed to the terminal

    area_median = median(area_list)                             # median area values
    for i in range(len(area_list)):                             # iteration over the facelets areas received
        delta_area=abs((area_list[i]-area_median)/area_median)  # area deviation from the median
        if delta_area > delta_area_limit:                       # filter on area deviating more than threshold
            to_exclude.append(i)                                # list of the contours to exclude is populated
            if debug:                                           # case debug variable is set true on __main__
                print('removed contour with area: ',area_list[i], " having delta_area of:",delta_area) # feedback is printed to the terminal

    if debug:                                                   # case debug variable is set true on __main__
        if len(to_exclude)==0 and len(area_list)>=9:            # case all the face facelets have been detected
            if side == 1:                                       # case the face is the first one (U)
                print("acceptable facelets area from min:",min_area, ",  to max:", max_area, ", with max area_delta <=", delta_area_limit)
            print("median facelets area:", area_median, "\tareas min:", min(area_list), "\tareas_max:", max(area_list))  # feedback is printed to the terminal
            print("minimum facelet area delta vs median:", round(abs((min(area_list)-area_median)/area_median),2))       # feedback is printed to the terminal
            print("maximum facelet area delta vs median:", round(abs((max(area_list)-area_median)/area_median),2))       # feedback is printed to the terminal
            print()
                      
    return to_exclude                # returns list of contours to be removed








def order_4points(pts, w, h):
    """ Based on: https://www.pyimagesearch.com/2016/03/21/ordering-coordinates-clockwise-with-python-and-opencv/
    Modified to only use Numby instead also Scipy library.
    This function orders the 4 vertex of (simplified) contours, so that the first one is top left (CW order)
    Argument is a contour
    Function returns a contour with coordinates ordered as per below sketch
    
    0  1
    2  3
    """
    
    xSorted = pts[np.argsort(pts[:, 0]), :]        # sort the points based on their x-coordinates
    leftMost = xSorted[:2, :]                      # grab the left-most point from the sorted x-coodinate points
    rightMost = xSorted[2:, :]                     # grab the right-most point from the sorted x-coodinate points
    
    # sort the left-most according to their y-coordinates, to grab the top-left and bottom-left points, respectively
    (tl, bl) = leftMost[np.argsort(leftMost[:, 1]), :]
    
    # Euclidean distance from top-left and right-most points: the point with largest distance will be bottom-right
    D = tl.reshape(1, 2)[:, np.newaxis, :] - rightMost[np.newaxis, :, :]   # matrix difference, by broadcasting tl and rightMost
    D = np.linalg.norm(D, axis=-1)[0]                                      # matrix distance of all rightMost vertices from tl
    
    (br, tr) = rightMost[np.argsort(D)[::-1], :]
    pts=np.array([tl, tr, br, bl])         # CW ordered coordinates, from top left, of the detected contour
    
    gap=3                                  # pixels for contour shifting toward inside and outside
    tl[0]=min(tl[0]+gap,w)                 # top left x coordinate, shifted toward the contour inner side
    tl[1]=min(tl[1]+gap,h)                 # top left y coordinate, shifted toward the contour inner side
    tr[0]=max(tr[0]-gap,0)                 # top right x coordinate, shifted toward the contour inner side
    tr[1]=min(tr[1]+gap,h)                 # top right y coordinate, shifted toward the contour inner side
    br[0]=max(br[0]-gap,0)                 # bottom right x coordinate, shifted toward the contour inner side
    br[1]=max(br[1]-gap,0)                 # bottom right y coordinate, shifted toward the contour inner side
    bl[0]=min(bl[0]+gap,w)                 # bottom left x coordinate, shifted toward the contour inner side
    bl[1]=max(bl[1]-gap,0)                 # bottom left y coordinate, shifted toward the contour inner side
    inner_pts=np.array([tl, tr, br, bl], dtype="int32")   # ordered coordinates, sligtly shifted toward the contour inner side
    
    gap=2*gap                              # pixels gap is doubled as it now refers to coordinates already shifted toward the inside
    tl[0]=max(tl[0]-gap,0)                 # top left x coordinate, shifted toward the contour outer side
    tl[1]=max(tl[1]-gap,0)                 # top left y coordinate, shifted toward the contour outer side
    tr[0]=min(tr[0]+gap,w)                 # top right x coordinate, shifted toward the contour outer side
    tr[1]=max(tr[1]-gap,0)                 # top right y coordinate, shifted toward the contour outer side
    br[0]=min(br[0]+gap,w)                 # bottom right x coordinate, shifted toward the contour outer side
    br[1]=min(br[1]+gap,h)                 # bottom right y coordinate, shifted toward the contour outer side
    bl[0]=max(bl[0]-gap,0)                 # bottom left x coordinate, shifted toward the contour outer side
    bl[1]=min(bl[1]+gap,h)                 # bottom left y coordinate, shifted toward the contour outer side
    outer_pts=np.array([tl, tr, br, bl], dtype="int32")   # ordered coordinates, sligtly shifted toward the contour outer side

    return pts, inner_pts, outer_pts







def order_9points(data, new_center):
    """ Based on: https://www.pyimagesearch.com/2016/03/21/ordering-coordinates-clockwise-with-python-and-opencv/
    Modified to only use Numby instead also Scipy library.
    This function orders the 9 countorus centers, with first one on top left, and order as per below sketch:
    
    0  1  2
    3  4  5
    6  7  8   """
    
    pts=np.zeros([9,2], dtype=int)                 # numpy array of zeros, having 9 items of two entries
    for i in range(len(data)):                     # iteration over the (9) facelets coordinates
        pts[i]=[data[i]['cx'], data[i]['cy']]      # numpy array is filled with the facelets centers coordinates
        
    xSorted = pts[np.argsort(pts[:, 0]), :]        # sort all the points based on their x-coordinates
    leftMost = xSorted[:3, :]                      # grab the left-most 3 points from the sorted x-coodinate points
    rightMost = xSorted[6:, :]                     # grab the right-most 3 points from the sorted x-coodinate points
    mid = xSorted[3:6, :]                          # remaining 3 points in the x middle
    ySortedMid = mid[np.argsort(mid[:, 1]), :]     # sorts the 3 points in the x middle by the y coordinate
    (tm, mm, bm) = ySortedMid                      # top-middle, middle-middle, bottom-midle points
    
    # sort the 3 left-most points according to their y-coordinates, to grab the top/mid/bottom one respectively
    leftMost = leftMost[np.argsort(leftMost[:, 1]), :]
    (tl, ml, bl) = leftMost
    
    # Euclidean distance from top-left and right-most points: the point with largest distance will be bottom-right
    D = tl.reshape(1, 2)[:, np.newaxis, :] - rightMost[np.newaxis, :, :]   # matrix difference, by broadcasting tl and rightMost
    D = np.linalg.norm(D, axis=-1)[0]                                      # matrix distance of all rightMost vertices from tl
    
    # sort the right-most according to their distance from top-left coordinate
    (br, mr, tr) = rightMost[np.argsort(D)[::-1], :]
    
    ordered_points = np.array([tl, tm, tr, ml, mm, mr, bl, bm, br], dtype="int32")   # ordered coordinates (centers of 9 facelets)   
    
    for coordinates in ordered_points:
        for i in range(len(data)):
            if data[i]['cx'] == coordinates[0] and data[i]['cy'] == coordinates[1]:        
                new_center.append(data[i])        # new_center is a new list with data ordered by xy coordinates
                data.pop(i)                       # used data-element is removed to speed up next iterations
                break                             # inner for loop can be break once the if found and data appended
    return new_center







def save_coordinates(coordinates):
    """Saves the coordinates of the 9 facelets to a text file.
        This action is done when a cubes_status is correctly determined.
        The 9 coordinates are averaged from the 6 faces."""
    
    coordinates = np.array(coordinates)                     # the coordinates list is converted to numpy array 
    avg = coordinates.mean(axis=0)                          # coordinates are averaged by 'columns'
    avg = np.round(avg, decimals=0).astype(int)             # coordinates are first rounded to 0 decimal then converted to integers
    avg = str(list(avg))                                    # coordinates are converted from array to list to string
    avg = avg.replace('[','').replace(']','').replace(' ','')+'\n'  # coordinates string without parentheses and empty spaces
    fname = 'Cubotino_m_coordinates.txt'                    # fname for the text file to retrieve the coordinates
    folder = pathlib.Path().resolve()                       # active folder (should be home/pi/cubotino/src)
    fname = os.path.join(folder, fname)                     # folder and file name for the coordinates, to be saved
    with open (fname, 'a') as f:                            # text file is opened to write on it in 'appending' mode
        f.write(avg)                                        # coordinates are saved to text file







def load_coordinates():
    """Loads the coordinates of the 9 facelets from a text file."""
    
    historical_data = False                                 # flag to track presence or assence of historical data is set False
    lines=[]                                                # lines variable is set as empty list
    fname = 'Cubotino_m_coordinates.txt'                    # fname for the text file to retrieve the coordinates
    folder = pathlib.Path().resolve()                       # active folder (should be home/pi/cubotino/src) 
    fname = os.path.join(folder, fname)                     # folder and file name for the coordinates, to be loaded
    
    if os.path.exists(fname):                               # case the coordinates file exists
        with open(fname, "r") as f:                         # settings file is opened in reading mode
            lines = f.read().splitlines()                   # all lines (without LF) are assigned as list to lines variable
        if len(lines)>=1:                                   # case the file has at least one row of data
            historical_data = True                          # flag to track presence or assence of historical data is set True
    else:                                                   # case the coordinates file does not exist
        print(f"Not found file {fname}")                    # print feedback to the terminal
        print("This file is generated by the robot at the first successfull cycle") # print feedback to the terminal

    corrupted_data = False                                  # corrupted_data is initially set False
    if historical_data:                                     # case there is historical data
        lines = [line.replace(' ', '') for line in lines]   # all spaces are removed
        valid_chars = set('0123456789,')                    # set of valid charcters (includes comma)
        for line in lines:                                  # iteration through the lines
            for c in line:                                  # iteration through the characters in line
                if c not in valid_chars:                    # case the character is not valid
                    corrupted_data = True                   # corrupted_data is set True
                    break                                   # inner for_loop s interrupted
            if corrupted_data:                              # case corrupted_data is True
                break                                       # outer loop_is interrupted
       
    if historical_data and corrupted_data:                  # case there is historical yet corrupted_data
        if debug:                                           # case debug is set true
            print(f"\nNot valid characters in {fname}")     # feedback is printed to the terminal
        new_lines=[]                                        # empty list to store the cleaned lines
        with open(fname, "w") as f:                         # settings file is opened in writing mode
            for line in lines:                              # iteration through the lines
                if not line.isspace():                      # case the line is not empty
                    keep_line=True                          # keep_line variable is initially set True
                    for c in line.strip().strip('\n'):      # iteration through the characters in line
                        if c not in valid_chars:            # case the character is not valid
                            keep_line=False                 # keep_line variable is set False
                            break                           # inner for_loop is interrupted
                    if keep_line:                           # case keep_line variable is (still) True
                        f.write(line)                       # that line is written to text file
                        new_lines.append(line)              # line is appended to lines
        
        if len(new_lines)>=1:                               # case the file has at least one row of data
            lines = new_lines                               # new_lines is assigned to lines
            if debug:                                       # case debug is set true
                print(f"The file got repaired")             # feedback is printed to the terminal
        else:                                               # case the remaining file does not have any row of data
            lines=[]                                        # lines variable is set as an empty list
            historical_data = False                         # historical data variable is set False
            
    if historical_data:                                     # case there is historical data
        if len(lines)>=1:                                   # case the file has at least one row of data
            for line in lines:                              # iteration over the lines
                if len(line)>35:                            # case the line has at least 35 characters
                    historical_data = True                  # flag to track presence or assence of historical data is set True
                else:                                       # case the line has at less than 26 characters
                    historical_data = False                 # flag to track presence or assence of historical data is set True
                    print("The file with facelets coordinates seems empty") # feedback is printed to the terminal
                    print("File will be filled and/or repaired the next time Cubotino_m.py is launched") # feedback is printed to the terminal
                    break                                   # for loop is interrupted
    
    if historical_data:                                     # case there is historical data
        # convert from string to integers and feed a list with coordinates values as tuple
        all_coordinates = []                                # empty list to store all the coordinates (prevoius solves cubes)
        for line in lines:                                  # iterating on each set of coordinates (each cube)
            coordinates=[]                                  # empty list to store the coordinated parsed from text to integers
            for i in range(17):                             # iterating over the 9 facelets of each cube set of coordinates
                val = int(line[: line.find(',')])           # coordinate is retrieved and converted to integer
                line = line[line.find(',')+1:]              # line is sliced for the remaining coordinates
                coordinates.append(val)                     # facelet coordinate is appended to the coordinates list
            coordinates.append(int(line))                   # the last facelet is appended to the coordinates list
            all_coordinates.append(coordinates)             # all the facelet coordinates are appended to all_coordinates list variable
        
        # limits the dataset to latest 5 cube readings saved (latest scans are more relevant, in case of settings changed at robot)
        n = len(all_coordinates)                            # quantity of coordinates sets (cubes) stored
        if n > 5:                                           # case there are more than 5 sets of coordinates (more than 5 cubes' history)
            all_coordinates = all_coordinates[-5:]          # only the last 5 are considered
        
        if n > 10:                                          # case there are more than 10 sets of coordinates (more than 5 cubes' history)
            remove_old_data(fname)                          # call a function that removes old data from the text file
        
        # average the coordinates from the dataset
        all_coordinates = np.array(all_coordinates)         # the list of lists all_coordinates is changed to a 2d numpy array
        avg = all_coordinates.mean(axis=0)                  # coordinates are averaged by 'columns'
        avg = np.round(avg, decimals=0).astype(int)         # coordinates are first rounded to 0 decimal then converted to integers
        avg = avg.tolist()                                  # coordinates are assigned to a list
        if debug:                                           # case debug is set true
            print("Loaded facelets coordinates:", avg)      # feedback is printed to the terminal
        return avg                                          # the average coordinates are returned
    
    else:                                                   # case there isn't historical data
        if debug:                                           # case debug is set true
            print("Not loaded facelets coordinates")        # feedback is printed to the terminal
        return []                                           # an empty list is returned 







def remove_old_data(fname):
    """"Removes excess data from the coordinates file (it keeps the last 5 rows)."""
    
    with open(fname, "r") as f:                             # settings file is opened in reading mode
        lines = f.readlines()                               # all lines are assigned as list to lines variable
        lines = lines[-5:]                                  # the last 5 lines are assigned to a local variable
    
    with open (fname, 'w') as f:                            # text file is opened to write on it (to empty it)
        f.write('')                                         # an empty character is saved
    
    with open (fname, 'a') as f:                            # text file is opened to write on it, in appending mode
        for line in lines:                                  # iteration over the lines variable
            f.write(line)                                   # line is written to file
    
    if debug:                                               # case debug is set true
        print(f"\nRemoved excessive data from {fname}")     # feedback is printed to the terminal







def cube_colors_interpr(BGR_detected):
    """ This function is used to decide wich color belongs to which facelet (cube's side) and related facelet position
    From the mean BGR color, detected per each facelet, the euclidean distance is calculated toward the 6 reference colors (centers).
    The basic principle is to measure the color distance from the cube's center facelets.
    
    Due to camera vignetting and light conditions, some color interpretation issues were sometimes happening (i.e. swapped red and orange)
    To solve this problem the reference colors are averaged with the just interpreted facelets (dinamic color references)
    In this approach the facelets need to be ordered by increasing distance from the reference; This allows to initially choose the more
    certain facelets, and use them to adapt the references.
    After completing this process, for all the facelets, the interpreted colors have to be ordered back to URFDLB order.
    
    In case the BGR color distance doesn't provide coherent result, a second approach based on HVS color space takes place."""

    # Step1: dict with BGR_detected and facelet's position as key
    #        dict with HSV (detected color) and facelet's position as key
    BGR_detected_dict={}                                    # empty dict to store the average BGR values detected per each facelet
    HSV_detected={}                                         # empty dict to store the average HSV values detected per each facelet
    for i in range(len(BGR_detected)):                      # iteration over the (expected 54) elemnt is list with avg BGR detected 
        BGR=BGR_detected[i]                                 # BGR detected on facelet i
        BGR_detected_dict[i]=BGR                            # BGR detected on facelet i is assigned to the dict, having the facelet i as key
        hsv = cv2.cvtColor( np.array([[[BGR[0],BGR[1],BGR[2]]]], dtype=np.uint8), cv2.COLOR_BGR2HSV)   # HSV color space
        HSV_detected[i]=(hsv[0][0][0],hsv[0][0][1],hsv[0][0][2])                                       # HSV tuple 

    if debug:                                         # case debug variable is set true on __main__
        print(f'\nBGR_detected: {BGR_detected}')      # feedback is printed to the terminal
        print(f'\nHSV: {HSV_detected}')               # feedback is printed to the terminal

    # Step2: detected BGR, of the center's facelets, are used as initial reference
    cube_ref_colors = {'white':BGR_detected[4], 'red':BGR_detected[13], 'green':BGR_detected[22],
                       'yellow':BGR_detected[31], 'orange':BGR_detected[40], 'blue':BGR_detected[49]}
    
    # Step3: dictionary with the color distances from the (initial) references
    color_distance={}                                             # empty dict to store all the color distances for all the facelets
    cube_ref_colors_lab={}                                        # empty dictionary to store color refences in Lab color space
    for color, BGR in cube_ref_colors.items():                    # iteration over the 6 centers
        B,G,R = BGR                                               # BGR values are unpact from the dict
        cube_ref_colors_lab[color]=tuple(rgb2lab([R,G,B]))        # BGR conversion to lab color space and dict feeding
            
    for facelet, color_measured in BGR_detected_dict.items():     # iteration over the 54 facelets
        B,G,R = color_measured                                    # individual BGR components
        lab_meas = rgb2lab([R,G,B])                               # conversion to lab color space (due CIEDE2000 function)
        distance=[]                                               # list with the distance from the 6 references, for each facelet
        for color, lab_ref in cube_ref_colors_lab.items():        # iteration over the 6 reference colors
            distance.append(CIEDE2000(tuple(lab_meas), lab_ref))  # Euclidean distance toward the 6 reference colors
        color_distance[facelet]=distance   # dict (facelet num as key) is populated with the measured distance from the 6 centes
    
    
    # Step4: Ordering the color distance (the min value per each facelet) by increasing values
    color_distance_copy=color_distance.copy()                     # a dict copy is made, to drop items while the analysis progresses
    color_distance_ordered={}                                     # empty dictiony to store the (min) color distance by increasing values
    for i in range(len(color_distance_copy)):                     # iteration over the dict copy
        key_min_dist = min(color_distance_copy,key=lambda key:min(color_distance_copy[key])) # dict key for the facelet with smaller color dist
        color_distance_ordered[key_min_dist] = color_distance_copy[key_min_dist]  # dict with facelets ordered by smaller distance, is populated
        color_distance_copy.pop(key_min_dist)   # removed the facelet from the dic copy, to search the next facelect with smaler color distance
    
    
    # Step5: List with facelets position ordered according to the color distance increasing order
    # this is needed to come back later to original URFDLB facelets order
    key_ordered_by_color_distance = [x for x in color_distance_ordered.keys()]


    # Step6: Ordering the facelets BGR color values according to color distance from the reference colors
    BGR_ordered={}
    for key in color_distance_ordered.keys():
        BGR_ordered[key]=BGR_detected[key]    # key is always the facelet number, yet the ordered dict is by increasing color distance


    # Step7: Color interpretation
    cube_status_by_color_distance={}          # dict to store the cube status reppresentation wih the interpreted colors
    distance={}                               # dict to store the color distance during each facelet check
#     distance_value=[]                       # list to store the color distance for the selectec color/facelet association
                                         
    for i, value in enumerate(BGR_ordered.values()):        # iteration on the facelet's BGR values ordered by increasing color distance from ref
        B,G,R = value
        lab_meas = rgb2lab([R,G,B])                                         # conversion to lab color space (due CIEDE2000 function)
        for color, lab_ref in cube_ref_colors_lab.items():                  # iteration over the 6 reference colors
            distance[color]=CIEDE2000(tuple(lab_meas), lab_ref)             # Euclidean distance toward the 6 reference colors
        color = min(distance, key=distance.get)                             # chosem color is the one with min distance from reference
  
        cube_status_by_color_distance[i]=color                              # dict of cube status wih the interpreted colors  
#         distance_value.append(distance[min(distance, key=distance.get)])  # list with the color distance of the chosen facelet's color
        distance.clear()                                                    # distance dict is cleared for the next facelet
        
        B_avg = math.sqrt((B**2+ (cube_ref_colors[color][0])**2)/2)     # average Red color is made from the chosen color and previous reference
        G_avg = math.sqrt((G**2+ (cube_ref_colors[color][1])**2)/2)     # average Green color is made from the chosen color and previous reference
        R_avg = math.sqrt((R**2+ (cube_ref_colors[color][2])**2)/2)     # average Blue color is made from the chosen color and previous reference

        cube_ref_colors[color]=(B_avg, G_avg, R_avg)                    # Color reference dict is updated with the new BGR averaged color
        cube_ref_colors_lab[color]=tuple(rgb2lab([R_avg,G_avg,B_avg]))  # Lab color space reference dict is updated with the new color reference 
    
    
    # Step8: Cube detection status is generated (a dict having the facelet number as key and the color as value)
    # colors are still as per the conventional one (URFDLB being White Red Green Yellow Orange Blue), later will match to those really detected at URFDLB
    cube_status={}
    for i in range(54):  # iteration over the 54 facelets
        cube_status[i]=cube_status_by_color_distance[key_ordered_by_color_distance.index(i)] # dict with facelet as key and color as value
    
    
    # Step9: Cube color sequence, to plot a realistic cube status detection (by colors, not by URFDLB letters)
    VS_value={}                            # dict to store the V-S (Value-Saturation) value of all facelets
    Hue={}                                 # dict to store the Hue value of all facelets
    
    i=0                                    # iterator index
    for H,S,V in HSV_detected.values():    # Hue, Saturation and Value are retrieved from the HSV dict
        VS_value[i]=int(V)-int(S)          # V-S (value-Saturation) value for all the facelet, populates the related dict
        Hue[i]=int(H)                      # Hue, for all the facelets, populates the related dict
        i+=1                               # iterator index is increased
    
    #step 10: function to get the color (sides) order, list of colored center's facelets and white center facelet
    # this depends on the cube orientation when dropped on the robot
    cube_color_sequence, HSV_analysis = retrieve_cube_color_order(VS_value, Hue)  # call to the specific function
    if debug:                                                   # case debug variable is set true on __main__
        print(f'\nCube_color_sequence: {cube_color_sequence}')  # feedback is printed to the terminal
    
    return cube_status, HSV_detected, cube_color_sequence, HSV_analysis






def retrieve_cube_color_order(VS_value,Hue):
    """ Determines the cube colors order, meaning the cube's orientation as it has been dropped on the robot.
    The function returns a list with the color order, as per URFDLB sequence.
    The function also returns a boolean if the HSV analysis has been coherent."""
    
    HSV_analysis=True                                      # flag used to validate the analysis
    
    centers=[4, 13, 22, 31, 40, 49]                        # facelets of the cube's sides centers 
    cube_color_sequence=[4, 13, 22, 31, 40, 49]            # list of center facelets, to later store the cube's side COLORS
    
    if debug:                                              # case debug variable is set true on __main__
        print(f'\nHue centers: {Hue[centers[0]]}, {Hue[centers[1]]}, '\
              f'{Hue[centers[2]]}, {Hue[centers[3]]}, {Hue[centers[4]]}, {Hue[centers[5]]}') # feedback is printed to the terminal
    
    VS_centers=[VS_value[facelet] for facelet in centers]  # V-S value measured on the cube side center under analysis
    Hcenters=[Hue[facelet] for facelet in centers]         # Hue value measured on the cube side center under analysis
    
    
    # white and yellow facelet face (center side facelet number)
    white_center=centers[VS_centers.index(max(VS_centers))]   # white center facelet (max V-S distinguishes the white)
    if white_center<27:                       # case the facelet id is < 27  
        yellow_center=white_center+27         # yellow center facelet (yellow is at opposite side of white, in this case requires adding 27)
    else:                                     # case the facelet id is > 27  
        yellow_center=white_center-27         # yellow is at opposite side of white, in this case by subtracting 27
    
    try:
        centers.remove(white_center)          # white facelet is removed from the list of center's facelets
    except:                                   # exception is raised if there are more white centers, in case of a bad color detection
        HSV_analysis=False                    # analysis according to HSV is set False
        if debug:                             # case debug variable is set true on __main__
            print('\nIssue with the white_center')   # feedback is printed to the terminal
    
    try:
        centers.remove(yellow_center)         # yellow facelet is removed from the list of center's facelets
    except:                                   # exception is raised if there are more yellow centers, in case of a bad color detection
        HSV_analysis=False                    # analysis according to HSV is set False
        if debug:                             # case debug variable is set true on __main__
            print('\nIssue with the yellow_center')    # feedback is printed to the terminal
       
    
    # searching for the red and orange cube's side
    for facelet in centers:                   # iteration on the 4 cube's remaining sides centers
        if facelet<27:                        # case the facelet id is < 27         
            opp_facelet=facelet+27            # opposite side center facelet, by adding 27
        elif facelet>27:                      # case the facelet id is > 27   
            opp_facelet=facelet-27            # opposite side center facelet, by subtracting 27
        Hc=Hue[facelet]                       # Hue value measured on the cube side center under analysis
        H_opp=Hue[opp_facelet]                # Hue value measured on the cube opposite side center

        if (Hc>150 and H_opp<30) or (Hc<30 and H_opp<30 and Hc<H_opp) or (Hc>160 and H_opp>170 and Hc<H_opp): # Hue filter for red vs orange
            red_center=facelet                # red center facelet
        elif (Hc<30 and H_opp>150) or (Hc<30 and Hc>H_opp) or (Hc>170 and Hc>H_opp):   # Hue filter for orange vs red
            orange_center=facelet             # orange center facelet
   
    try:
        centers.remove(red_center)            # red facelet is removed from the list of center's facelets
    except:                                   # exception is raised if there are more red centers, in case of a bad color detection
        HSV_analysis=False                    # analysis according to HSV is set False
        if debug:                                   # case debug variable is set true on __main__
            print('\nIssue with the red_center')    # feedback is printed to the terminal
    
    try:
        centers.remove(orange_center)         # orange facelet is removed from the list of center's facelets
    except:                                   # exception is raised if there are more orange centers, in case of a bad color detection
        HSV_analysis=False                    # analysis according to HSV is set False
        if debug:                             # case debug variable is set true on __main__
            print('\nIssue with the orange_center')   # feedback is printed to the terminal
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
