AndreaFavero71/CUBOTino_micro/(commit log)

2023-02-05 Initial commit.
    [Baseplate.stp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]
2023-03-04 First release
    [Baseplate.stp, Cover.stl, Cover.stp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]
2023-03-11 Initial release
    [Cover.stl]
2023-03-19 GUI support image crop and warp
    Image cropping and warping parameters can be adjusted via GUI support: Cubotino_m_servos_GUI.py
    [Cubotino_m.py, Cubotino_m_servos.py, Cubotino_m_servos_GUI.py]
2023-03-25 gerber files V1
    [Drill_PTH_Through.DRL, Drill_PTH_Through_Via.DRL, Gerber_BoardOutlineLayer.GKO, Gerber_BottomLayer.GBL, Gerber_BottomSilkscreenLayer.GBO, Gerber_BottomSolderMaskLayer.GBS, Gerber_TopLayer.GTL, Gerber_TopSilkscreenLayer.GTO]
2023-03-25 act_led
    Added act-led to remote the led to the Connection_board.
    Uncomment last row at /boot/config.txt (via sudo)
2023-04-30 Correct bug on ACT led pin
    The Gerber files use GPIO6 (and not 5) for ACT led function
2023-05-06 Rev 0.5
    Another bug on the mac address system used to match different settings for different robots.
    [Cubotino_m.py, Cubotino_m_display.py, Cubotino_m_servos.py, Cubotino_m_servos_GUI.py]
2023-05-06 Additional (extensible) baseplate
    A way to increase stability without increasing much in dimensions
    [Baseplate_L_leg.stl, Baseplate_R_leg.stl, Baseplate_addition.stl, Cover_led_hole.stl]
2024-01-12 Renamed Servo_axes files and Updated How_to doc
    Fully revisited Instructions to improve content and readability.
    Added info for ACT-LED on perfoboard, and 3D files (Cover_led_perfboard_hole).
    Renamed the Servo_axis files in SOC
    [Cover_Perfboard_hole.stl, Cover_Perfboard_hole.stp, SOC_+5.stl, SOC_+5.stp, SOC_+9.stl, SOC_+9.stp, SOC_-5.stl, SOC_-5.stp]
2024-02-22 Update Cubotino_m_display.py
    Solve bug when pillow >= 9.5
    [Cubotino_m_display.py]
2024-03-15 Rev 1.0
    Added Fix Coordinates System (FCS).
    Rationalized settings management.
    Added animation.
    [Cubotino_m.py, Cubotino_m_display.py, Cubotino_m_servos.py, Cubotino_m_servos_GUI.py, Cubotino_m_settings_manager.py]
2024-04-11 rev 1.1
    Cubotino_m.py: Fixed bug at animation-start (when not found 6 different colours at centres).
    GUI: Fixed minor bug at Warp_slicing slider (float instead of Integer).
    [Cubotino_m.py, Cubotino_m_servos_GUI.py]
2024-04-15 Rev 1.1 corrected bug
    robot_move_cube function call only when screen presence (indentation error).
    [Cubotino_m.py]
